IamSid44/VLSI-Project/Static Implementation/FPGA/CLA_4_Bit.runs/impl_1/.init_design.begin.rst

<?xml version="1.0"?>
<ProcessHandle Version="1" Minor="0">
    <Process Command=".planAhead." Owner="sidda" Host="ASUS-VIVOBOOK" Pid="15584">
    </Process>
</ProcessHandle>
