IamSid44/VLSI-Project/Static Implementation/FPGA/CLA_4_Bit.runs/impl_1/.vivado.begin.rst

<?xml version="1.0"?>
<ProcessHandle Version="1" Minor="0">
    <Process Command="vivado.bat" Owner="sidda" Host="ASUS-VIVOBOOK" Pid="15996" HostCore="16" HostMemory="016539365376">
    </Process>
</ProcessHandle>
