IamSid44/VLSI-Project/Static Implementation/FPGA/CLA_4_Bit.runs/synth_1/.vivado.begin.rst

<?xml version="1.0"?>
<ProcessHandle Version="1" Minor="0">
    <Process Command="vivado.bat" Owner="sidda" Host="ASUS-VIVOBOOK" Pid="4608" HostCore="16" HostMemory="016539365376">
    </Process>
</ProcessHandle>
