IamSid44/VLSI-Project/2023102040_VLSI_Project.pdf

# Design and Implementation of a 4 Bit CLA

Siddarth Gottumukkula
2023102040
Department of Electronics and Communication Engineering IIIT Hyderabad
siddarth.g@students.iiit.ac.in

Abstract—This project focuses on the design and implementation of a 4-bit Carry Look-Ahead Adder (CLA), a highperformance digital circuit for binary addition. The CLA architecture is chosen for its ability to significantly reduce propagation delay compared to traditional ripple carry adders, making it suitable for high-speed arithmetic operations in modern digital systems. Performance metrics, such as delay, power consumption, gate count, are evaluated to demonstrate the efficiency of the CLA. Data collection and simulations have been done using tools like NGSPICE, MAGIC layout tool and AMD Xilinx Vivado. This project aims to provide insights into efficient adder design techniques.

I. INTRODUCTION
Addition is a fundamental operation in digital systems, forming the basis of arithmetic and logic computations in processors, ALUs, and other hardware components. While traditional ripple carry adders (RCAs) offer a straightforward implementation, their performance is hindered by carry propagation delays, which grow linearly with the number of bits. To address this bottleneck, the Carry Look-Ahead Adder (CLA) employs a parallelized approach to generate and propagate carry signals, enabling faster computation (the worst case delay remains the same in both the implementations but the performance is much better on average). By precomputing carry signals based on input bits and leveraging efficient logic design, the CLA minimizes delay, making it a preferred choice for high-speed arithmetic operations.
A. Carry Look-Ahead Logic
The CLA uses the concepts of generate and propagate signals to precompute carry signals [2]. For two input bits Ai and Bi
, and the carry-in Ci−1 for bit i (The first bit will have a Cin and the final carry of the operation will be C3):
- Generate Signal (Gi): The generate signal determines if a carry will be generated at bit i, regardless of the input carry.
Gi = Ai
- Bi
- Propagate Signal (Pi): The propagate signal indicates if a carry from the previous stage will propagate through bit i.
Pi = Ai ⊕ Bi
- Carry-Out (Ci): The carry-out for each bit is computed using the generate and propagate signals:

Ci = Gi + (Pi

- Ci−1)
1) Carry Signal Evaluation: Using the carry-out equation recursively, the carry signals can be computed for all 4 bits as follows:

C0 = G0 + (P0 · Cin)
C1 = G1 + (P1 · C0) = G1 + P1 · (G0 + P0 · Cin)
C2 = G2 + (P2 · C1) = G2 + P2 · (G1 + P1 · (G0 + P0 · Cin))

This recursive method eliminates the need for sequential carry propagation, enabling parallel computation of carry signals.
2) Sum Signal Evaluation: Once the carry signals are determined, the sum for each bit is calculated using the XOR operation:
Si = Pi ⊕ Ci−1

The optimizations used and implementation details are discussed in this project.

B. Integration of Flip-Flops for Timing Stability

To ensure robust operation and eliminate timing issues, flip-flops are integrated at both the input and output stages of the Carry Look-Ahead Adder (CLA). This design choice ensures proper synchronization of signals and prevents glitches or metastability that could occur due to timing mismatches or high-frequency operations.

By clocking both the input and output flip-flops, the circuit aligns its operations with the system clock, eliminating race conditions and ensuring consistent timing. Output flip-flops store the final results of the CLA computation, ensuring that the outputs are held steady until the next clock cycle. This prevents premature changes in the outputs during high-speed operations.

The flip-flops are strategically placed to encapsulate the CLA logic. Each input signal (Ai
, Bi

, and C0) is fed into a
D flip-flop, clocked by a common system clock. This ensures that all input signals are synchronized before being processed by the CLA logic. The computed carry (C3) and sum bits (S0, S1, S2, S3) are captured by another set of D flip-flops at the output. This locks the results and prevents any glitches from propagating downstream.

II. FLIP-FLOP DESIGN
In this project, a True Single-Phase Clock (TSPC) D-Flip-Flop is employed for input and output synchronization in the Carry Look-Ahead Adder (CLA) circuit. The TSPC flip-flop is chosen for its simplicity, low power consumption, less area, and ability to operate at high frequencies, making it an ideal choice for high-speed digital systems [3].
A. Structure of the TSPC D-Flip-Flop
The TSPC D-Flip-Flop operates with a single clock phase, avoiding the need for complementary clock signals, which simplifies clock distribution. It consists of two main stages, a low level sensitive latch followed by a high level sensitive latch.

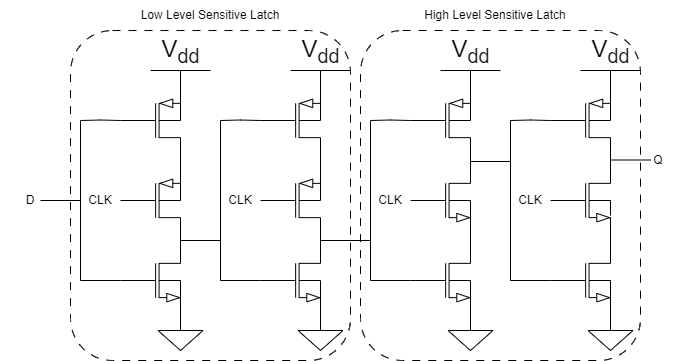
[picture p1: figure]

Fig. 1. TSPC D Flip-Flop circuit

The TSPC flip-flop’s operation is divided into two phases:
1) During the clock’s low phase (CLK = 0), the low level sensitive latch records the input but the output does not change as the high level sensitive latch is turned OFF.
2) During the clock’s high phase (CLK = 1), the low level sensitive latch turns OFF and the high level sensitive latch turns ON sending the previously recorded input to the output. Any change in the input in this phase will not affect the output.

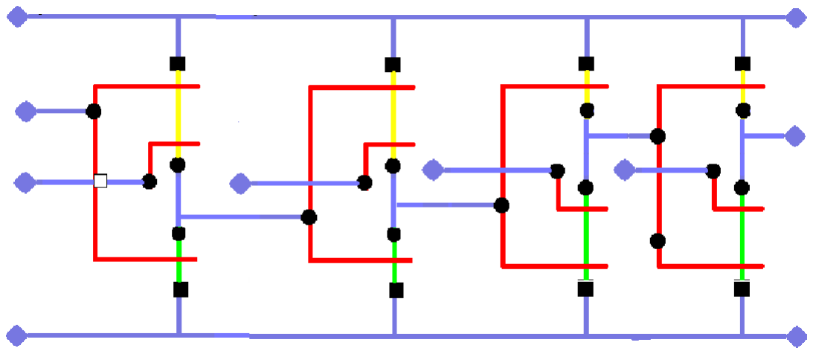
[picture p2: figure]

Fig. 2. Stick Diagram of the TSPC D FLip FLop

B. Timing Constraints
The TSPC D-Flip-Flop introduces certain timing constraints that must be satisfied for reliable operation:
- Setup Time (Tsetup): The minimum time the input data
(D) must be stable before the clock edge.
- Hold Time (Thold): The minimum time the input data
(D) must remain stable after the clock edge.
- Clock-to-Q Delay (TCQ): The time it takes for the output
(Q) to reflect a change in the input (D) after the clock edge.

The following table summarizes the relevant parameters of the TSPC D-Flip-Flop used in this project:

The optimizations used are listed below.

1) To reduce the body effect which might adversely affect the circuit, we short the bulk terminal to the source, instead of connecting it to the highest or the lowest voltage terminal in the circuit. This sets VSB = 0 and the threshold voltage remains unchanged in our analysis.
2) The widths of the PMOS transistors are scaled to twice the widths of the NMOS transistors in order to match the current carrying capabilities. This minimizes the difference in the rise and fall delays.

TABLE I
SIZING USED IN THE TSPC D FF, λ = 0.09µm
Element | PMOS | NMOS
Low Level Latch | 40λ | 10λ
High Level Latch | 20λ | 20λ

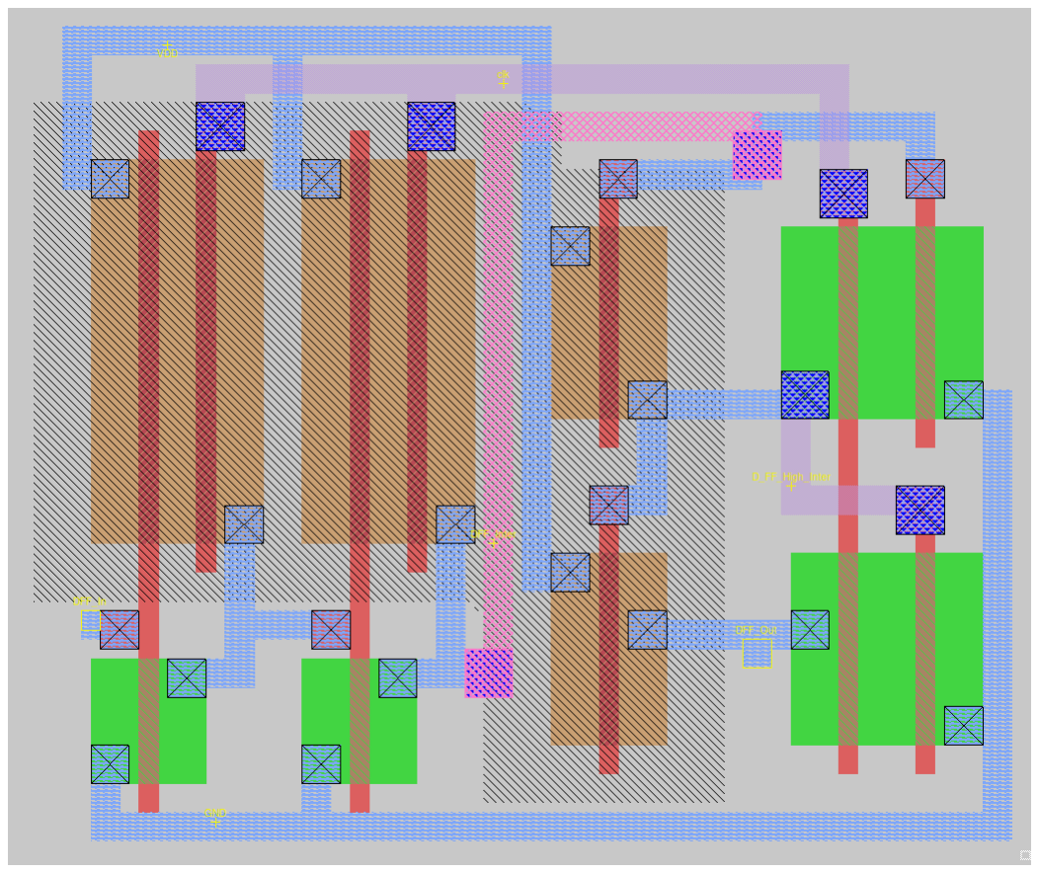
[picture p3: figure]

Fig. 3. Layout of TSPC D FF

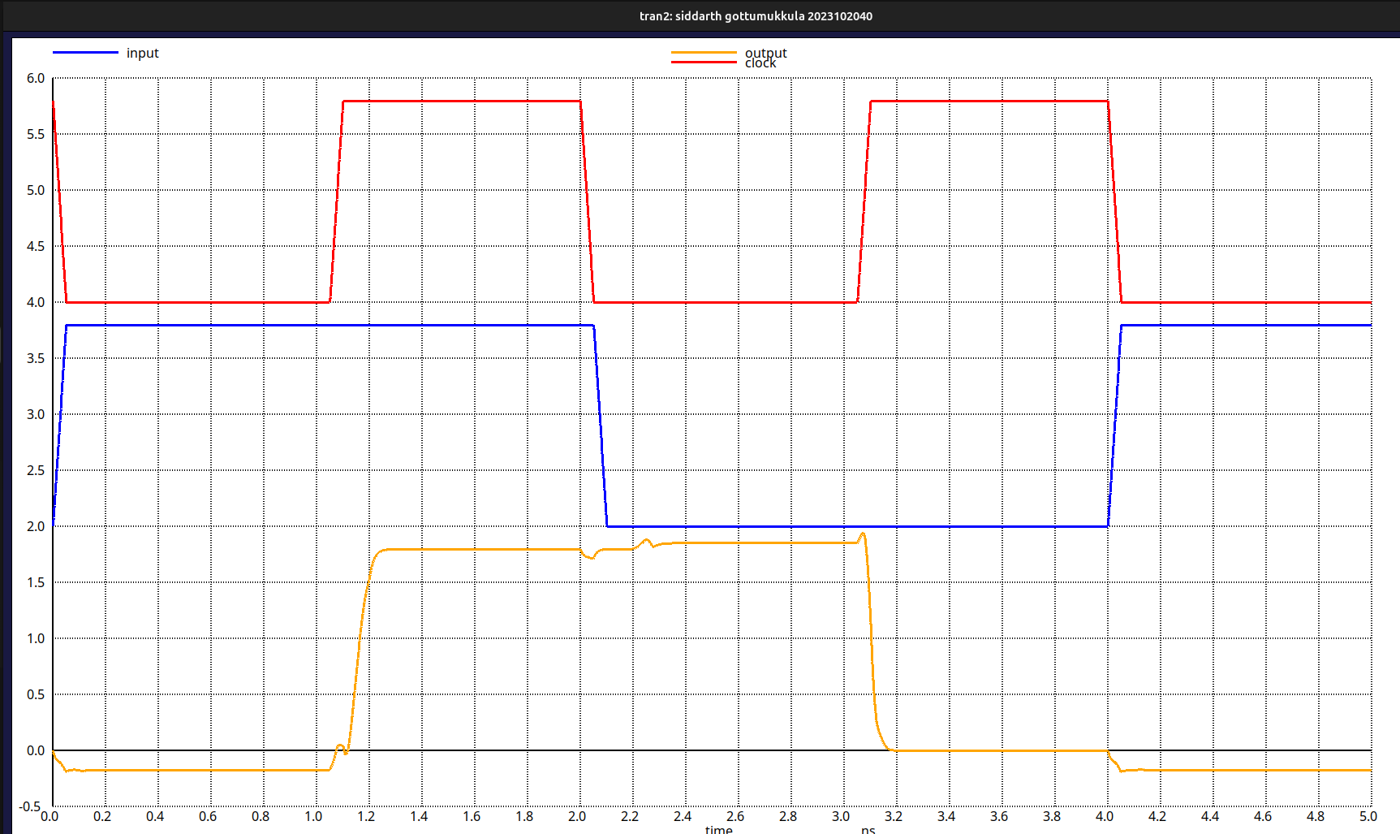
[picture p4: figure]

Fig. 4. Pre Layout Output of the FF

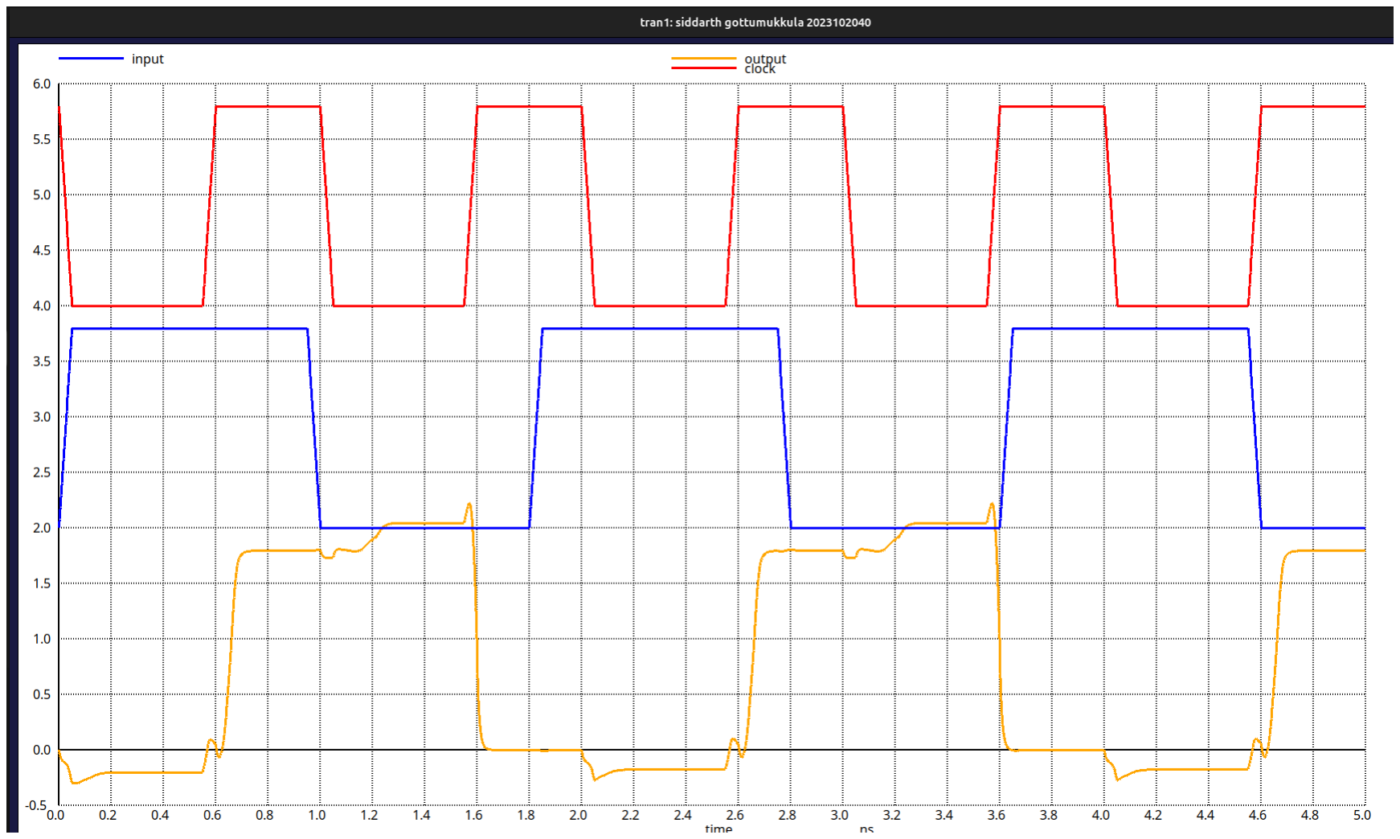
[picture p5: figure]

Fig. 5. Post Layout Output of the FF

The Flip-Flop was simulated using NGSPICE pre layout and post layout. The layout was done using MAGIC Layout tool. We expect differences in the values obtained pre layout and post layout not only due to parasitic capacitances present but also because of layout optimization techniques used. For example, the same diffusion region can act as the drain and source of two transistors instead of a wire connecting two separate regions. This cumulatively saves a huge amount of silicon area.

TABLE II
TSPC D-FLIP-FLOP PERFORMANCE DATA
Parameter | Pre Layout | Post Layout
Setup Time (Tsetup) | 121.97 ps | 129.57 ps
Hold Time (Thold) | 0 ps | 0 ps
Clock-to-Q Delay (Tclk to Q) | 84 ps | 82.7 ps

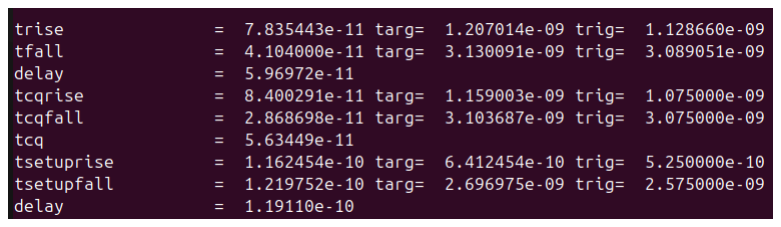
[picture p6: figure]

Fig. 6. Various parameters Pre Layout

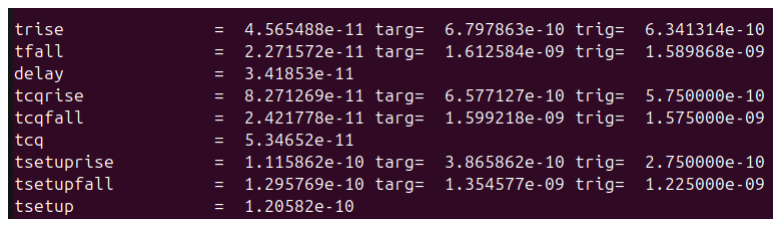
[picture p7: figure]

Fig. 7. Various parameters Post Layout

III. CLA IMPLEMENTATION

The implementation of the Carry Look-Ahead Adder (CLA) in this project focuses on achieving high-speed, powerefficient, and robust operation. A static CMOS logic style is chosen for the CLA circuit, as it offers several advantages over other logic styles, including dynamic logic and alternative static implementations.

A. Choosing a Logic Style

Static logic styles are preferred over dynamic logic styles in this design for the following reasons:
- Output Requirements: Given the constraint that the output must appear before at the next clock edge, there isn’t much flexibility to choose dynamic lofic styles. Implementing the different sections of the CLA using dynamic logic would take many clock cycles to produce the correct output. One strong contender in dynamic logic was to break the CLA implementation into two stages and use level sensitive logic implementations but it has other intricate complexities coming with it which are explained below.
- Charge redistribution: Static logic eliminates the risk of charge leakage and redistribution over time, which can lead to incorrect outputs in dynamic circuits. Solving this issue in dynamic circuits requires additional Keeper circuitry.
- Power Consumption: Unlike dynamic logic, static logic does not require precharge and evaluation phases, reducing the overall power consumption in the circuit. Static CMOS logic is used specifically for the CLA implementation due to its balance of performance, power, and reliability:
- Low Power Consumption: CMOS logic consumes power only during transitions, making it highly energyefficient compared to other static styles like pseudo-NMOS or pass-transistor logic.
- High Noise Margin: CMOS gates provide high noise margins, ensuring robust operation even under variations in supply voltage or process parameters.
- Design Simplicity: CMOS logic gates are straightforward to design and verify, reducing the complexity of the CLA implementation. item BiCMOS technology is another good option. However, circuits employing this style use the different families of transistors to their advantage. The bipolar junction transistors are used to handle the analog section (RF) of the circuit and the

CMOS technology is used to handle the ‘sea of logic’ [4]. Thus, for our purposes, BJT’s aren’t really necessary.

B. Circuit Implementation

The most basic circuit one can make is directly from the CLA expressions discussed in the introductory section, using OR and AND gates and XOR gates. However, we know that implementing a non-inverting logic will take up more resources. A possible implementation is to use NAND and NOR gates, the simplest implementation for which is detailed in [5]. A potential problem with this circuit is that a large number of inputs to a gate will result in a large capacitance, which will make the delay larger. We want to implement a circuit with a smaller parasitic capacitance, i.e., a smaller number of inputs. With a slight manipulation of the logic expressions, we observe that an implementation with just two input gates in possible [1]. We will explore this implementation further.

Another interesting implementation could be generating the output bits using a large single PUN and PDN [6]. However, to sizing of each of the transistors would be significantly higher than the basic implementation. The complexity also increases. Though it may prove to be faster due to lesser number fo logic stages the signal has to propagate through, the capacitance and the area would be drastically higher.

Another optimization that can be made to reduce the parasitic capacitance is to primarily use NOR gates instead of NAND gates. This will reduce the capacitance seen by the output node. The reason for this is that the PMOS stack will have a larger capacitance than the NMOS stack due to the sizing. Notice that the XOR in the Propagate signal can be changed to OR without affecting the output. This will reduce the complexity of the circuit. Let us redefine our logic expressions to inculcate these changes.

Pi = Ai + Bi for i ∈ {0, 1, 2, 3}

Gi = Ai

- Bi for i ∈ {0, 1, 2, 3}

Pi = Ai + Bi for i ∈ {0, 1, 2, 3}

Gi = Ai

- Bi for i ∈ {0, 1, 2, 3}

Pi

is the NOR of the input bits and Gi is the NAND of the
input bits.

C0 = G0 + P0 · Cin

= G0 · (P0 · Cin)

= G0 · (P0 + Cin)
C1 = G1 + P1 · G0 + P1 · P0 · Cin

= G1 · (P1 + G0) + (P1 + P0) · Cin
C2 = G2 + P2 · G1 + P2 · P1 · G0 + P2 · P1 · P0 · Cin

= G2 · (P2 + G1) + P2 · P1 · (G0 + P0 · Cin)

= G2 · (P2 + G1) + (P2 + P1) · G0 · P0 · Cin

= G2 · (P2 + G1) + (P2 + P1) · G0 · P0 + Cin C3 = G3 + P3 · G2 + P3 · P2 · G1 + P3 · P2 · P1 · G0 + P3 · P2 · P1 · P0 · Cin

We decompose C3 into two different intermediate expressions.

C3 = Gout + Pout · Cin

= Gout · (Pout + Cin)
Gout = G3 + P3 · G2 + P3 · P2 · G1 + P3 · P2 · P1 · G0
= G′
3
- (P

′

3 + G′
2

)

+ (P

′
3 + P

′
2

) · G′
1
- (P

′

1 + G′
0

)

Pout = P3 · P2 · P1 · P0

= P

′
3 + P

′
2
- P

′
1 + P

′
0

The stick diagrams of the logic gates used are drawn [8] and the sizing is explained in the later part of this section. The circuit implementing the logic can be designed as shown in [1].

TABLE III
LEGEND FOR THE STICK DIAGRAMS
Element | Color/Symbol
Metal 1 | Blue
P Diffusion | Yellow
N Diffusion | Green
Polysilicon | Red
Contact | Black Circle
Contact & Tap | Black Square
Metal 1 Port | Blue Diamond

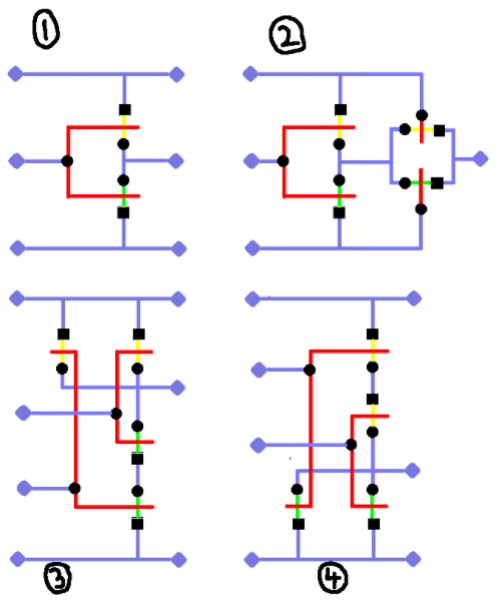
[picture p8: figure]

Fig. 8. Stick Diagrams of the gates NOT, XOR [9], NAND, NOR. These structures show how the transistors are connected in NGSPICE and MAGIC(for NOT and XOR). The color mapping is given below.

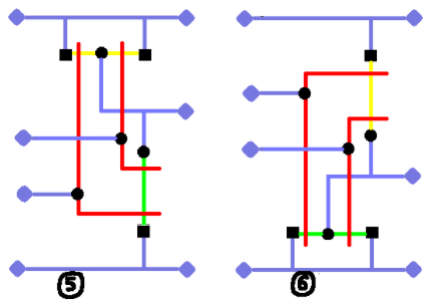
[picture p9: figure]

Fig. 9. In MAGIC, the common terminals are connected as shown for NAND and NOR gates. This gives us different results than the expected values from NGSPICE

To decide the sizing of the gates, we can use the method of logical effort [7]. The circuit, however, is too complex with multiple paths. Optimizing for a critical path might change the critical path which we will have to iterate over again. Thus, I have used a few general inferences to improve the circuit. For instance, the NAND and NOR gates which generate Gi and Pi are made larger to increase the driving capability. This trend can be seen from MLE as well. The logic gates in the middle section which compute the carry are sized smaller than the first layer of gates and the logic gates towards the end, before the output, are the smallest. This ensures less load and optimal current driving capabilities for each of the stages. The gate sizes are given in the table ?? and circuit diagram ?? has numbers on the logic gates indicating the types of gates used.

TABLE IV
SIZING USED IN THE TSPC D FF, λ = 0.09µm
Element | PMOS | NMOS | Numbering
Inverter | 22λ | 11 λ | 1
Small NOR | 10λ | 5λ | 2
Medium NOR | 40λ | 20λ | 3
Large NOR | 80λ | 40λ | 4
Small NAND | 20λ | 20λ | 5
Large NAND | 40λ | 40λ | 6

The XOR gate’s (7) Inverter part is made using the same parameters specified above. The analog transmission gate is made using Wp = 21λ, Wn = 5λ, these are the values that just satisfy all the DRCs. The AND gate (8) is made using the NAND gate and the Inverter. The OR gate (9) is made using the Medium NOR gate and the inverter. The values were initialized in an attempt to match the resistance to an inverter and later iterated over to find the current set of values.

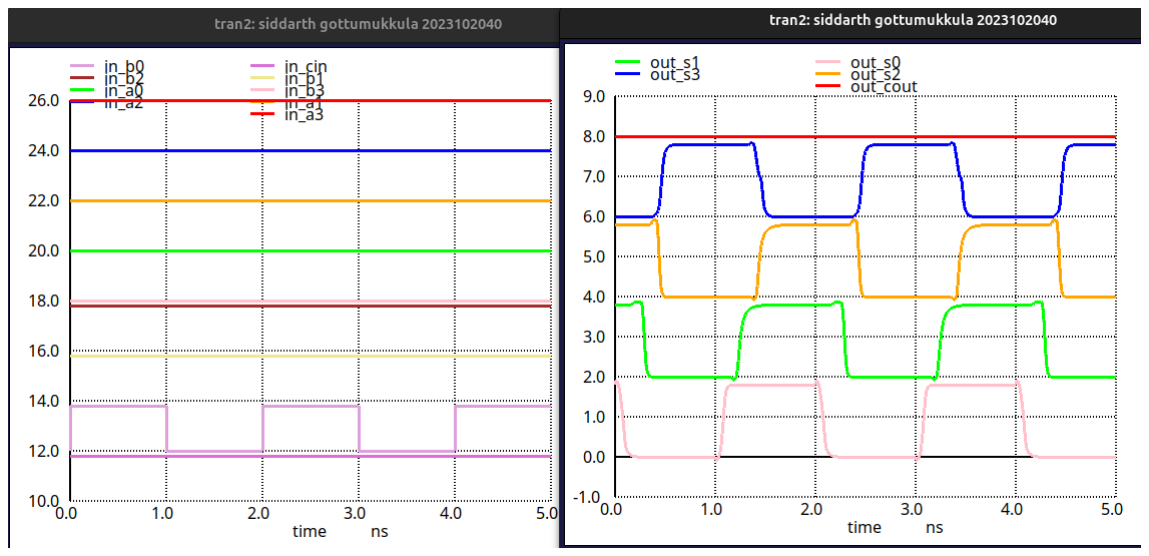
[picture p10: figure]

Fig. 10. CLA Pre Layout Output for the case, A = 0000, B = 0110 → 0111, C = 1. This is a case which tests the critical path from B0 to S3

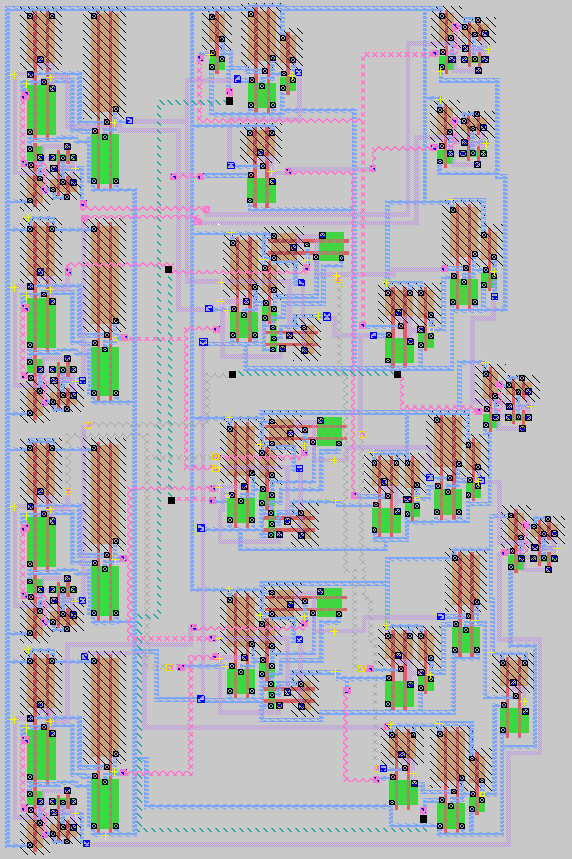
[picture p11: figure]

Fig. 11. CLA Layout

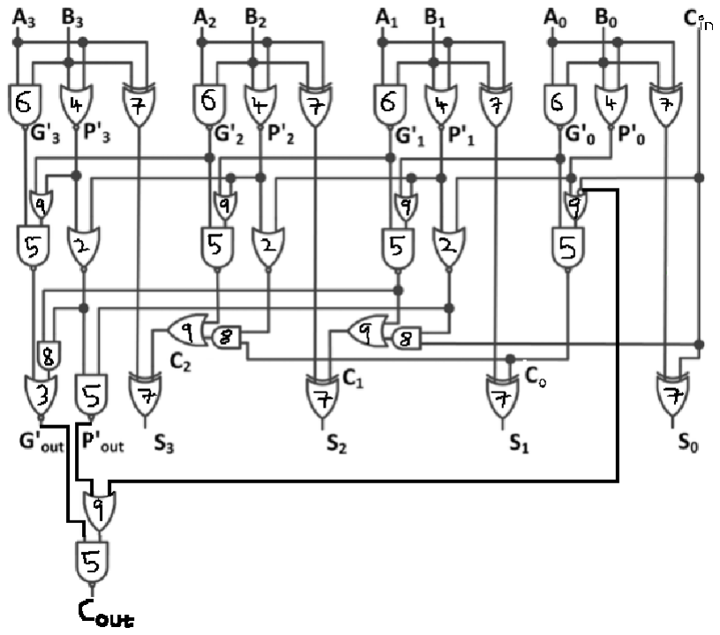
[picture p12: figure]

Fig. 12. Circuit Diagram [1] with gates numbered as mentioned in the table above

The critical path in the circuit would be one from B0 to S3. The critical path can be figured out by counting the number of gates in the path. We will take a test case and analyze the same test case in all the simulations unless stated otherwise.

The circuit can be broken down and implemented in three layers. The first layer generates the P and G signals along with a partial Sum bit signal. The next layer will involve intermediate computation of the carry bits and the final layer will compute the sum bit and produce the output ultimately.

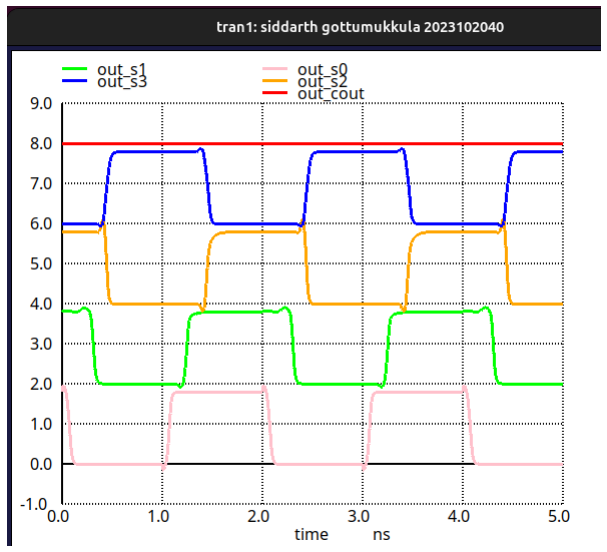
[picture p13: figure]

Fig. 13. CLA Post Layout Output for the same case

TABLE V
PARAMETERS OF THE 4-BIT CARRY LOOKAHEAD ADDER
Parameter | Value
Pre-Layout Propagation Delay (ns) | 459.98 ps
Post-Layout Propagation Delay (ns) | 449.57 ps
Pre-Layout Power Delay Product (PDP) | 20.7 pJ
Post-Layout Power Delay Product (PDP) | 20.23 pJ
Power Dissipation (mW) | 45 mW
Gate Count (Layout) | 54
Transistor Count (Layout) | 182
Layout Area | 2585.73 µm²
Horizontal Pitch | 41.22 µm
Vertical Pitch | 62.73 µm

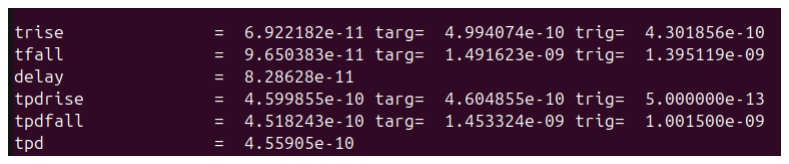
[picture p14: figure]

Fig. 14. Parameters Pre Layout for CLA

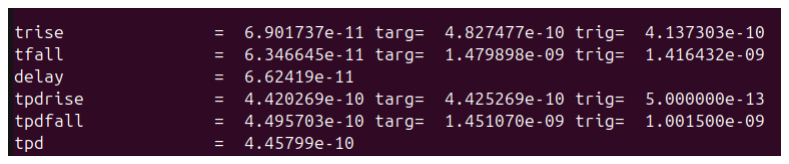
[picture p15: figure]

Fig. 15. Parameters Post Layout for CLA

Theoretically, we can come up with a bound for the maximum frequency using Static Timing Analysis.

tCQmax + tpdmax + tsu ≤ TClk

Using the above equation and the values extracted earlier, we get,

fmaxP relayout = 1.502 GHz

fmaxP ostlayout = 1.511 GHz

We will compare the actual frequency of operation obtained with this value later on.

IV. INTEGRATION
Floor planning has to be proper to ensure optimal circuit area.

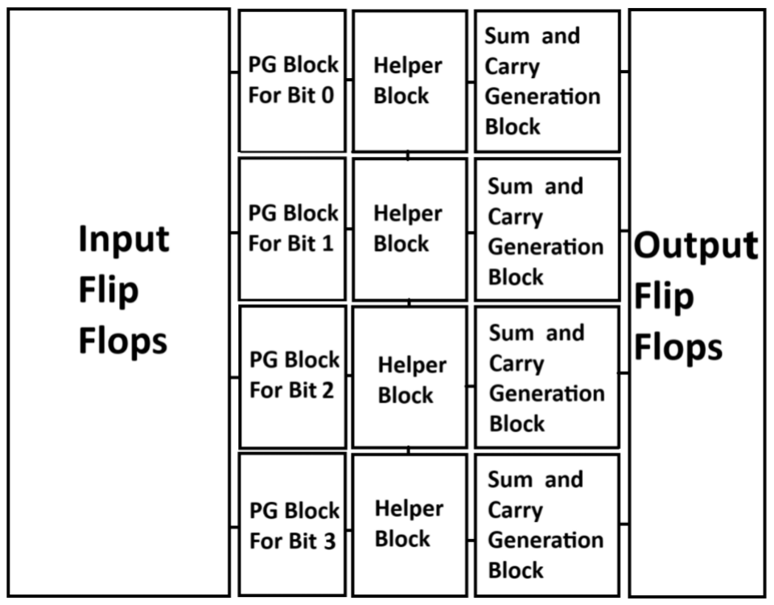
[picture p16: figure]

Fig. 16. Floor Plan for the Layout. The circuit is divided into these sub blocks and implemented for modularity

The circuit designing and performance metrics are specified below. They are extracted with an inverter

20λ
10λ
as load at each
of the flip flop outputs.

TABLE VI
PRE-LAYOUT VS POST-LAYOUT PARAMETERS OF THE 4-BIT CLA
Parameter | Value
Circuit Area | 4477.81 µm²
Transistor Count | 360
Horizontal Pitch | 62.82 µm
Vertical Pitch | 71.28 µm
Max Frequency Pre-Layout | 1.136 GHz
Min Time Period Pre-Layout | 0.88 ns
Max Frequency Post-Layout | 1.19 GHz
Min Time Period Post-Layout | 0.84 ns

We see that the maximum frequency of operation is 0.3 GHz lesser than what is expected theoretically. This arises due to various parameters such as loading and parasitics.

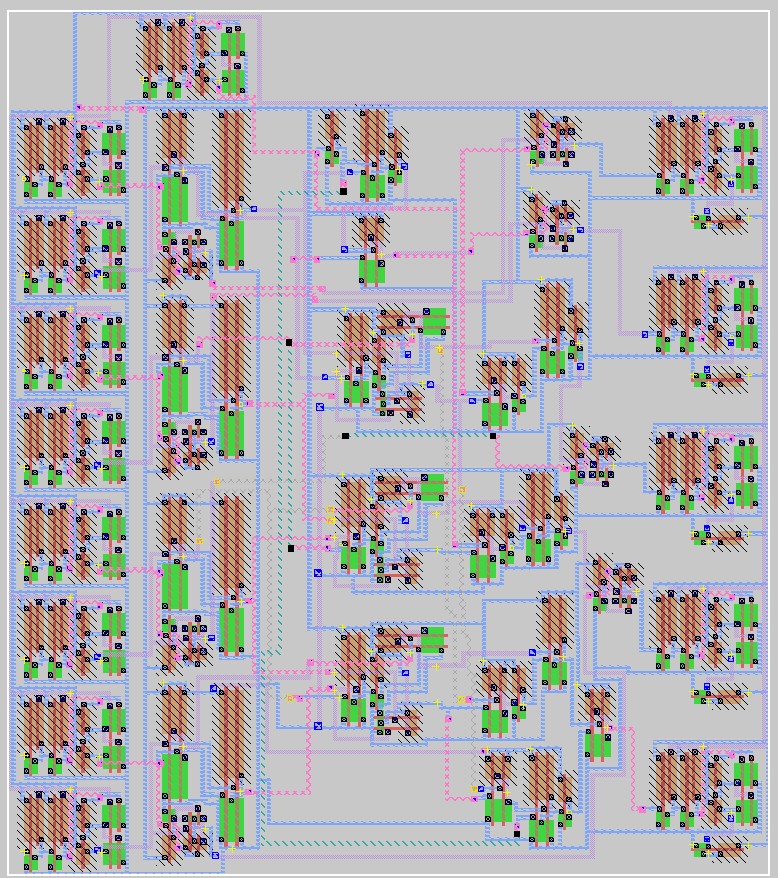
[picture p17: figure]

Fig. 17. Full Circuit Layout

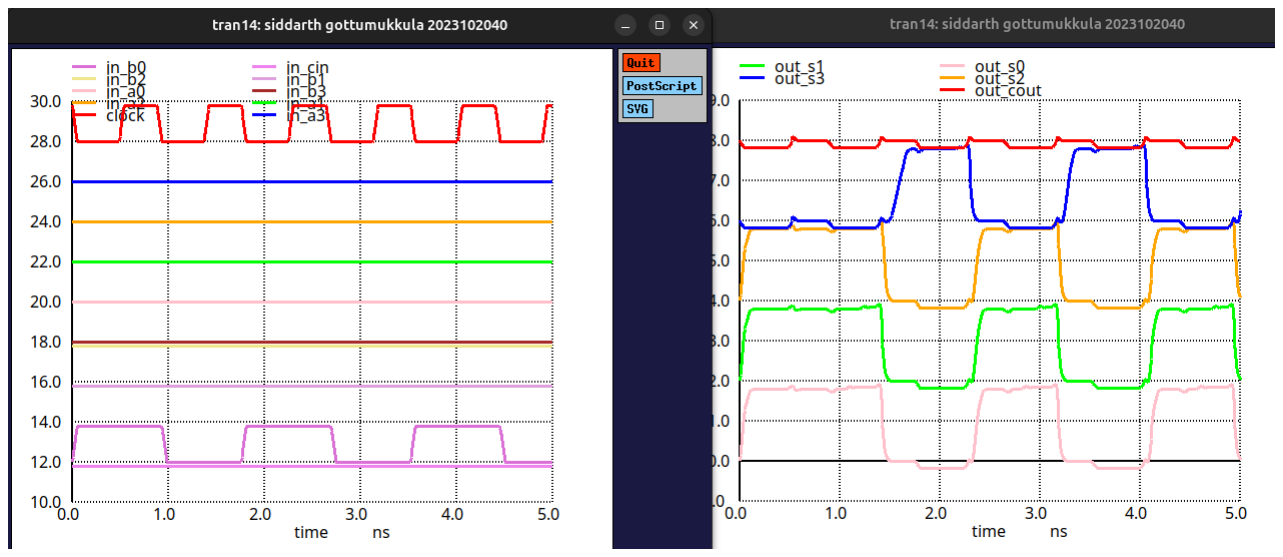
[picture p18: figure]

Fig. 18. Pre Layout Circuit operating at 1.136 GHz for the same critical test case

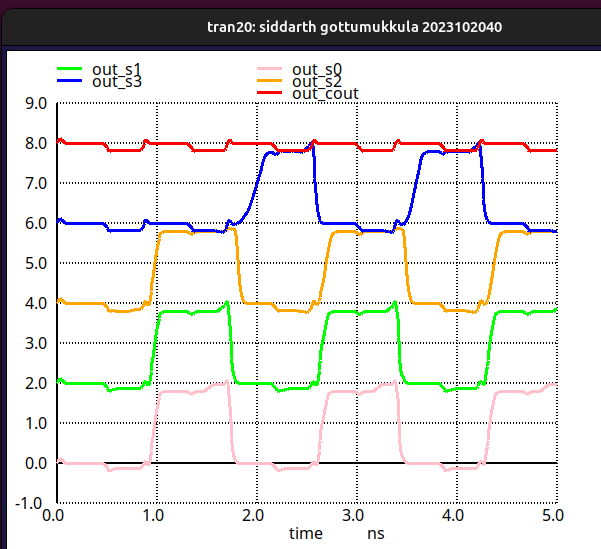
[picture p19: figure]

Fig. 19. Post Layout circuit operating at 1.19 GHz

We can verify the timing of the input and the output using Verilog. In structural level code, we need not worry about the sizing or voltage levels. It is purely for logic simulation and timing analysis which gives us insights into the working of the circuit.

Implementation has been carried out on the Xilinx Spartan-7 Boolean FPGA board. Using the PMOD pins, the output has been plotted on an Oscilloscope.

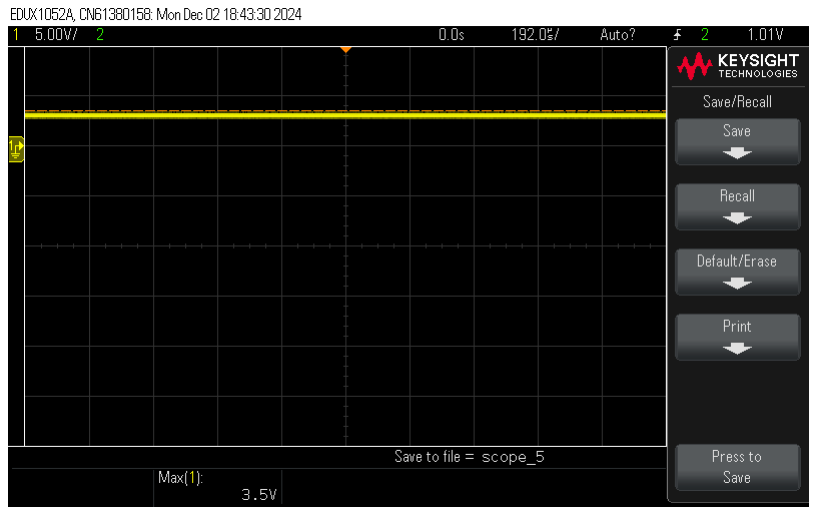
[picture p20: figure]

Fig. 21. Carry Bit for the input A = 13 (1011), B = 7 (0111), Cin = 1. The FPGA board outputs values between 0 V and 3.3 V through the PMOD pins. In the oscilloscope plots, 3.3 V is to be treated as logic level 1 and 0 is supposed to be treated as logic level 0. However, values observed are not exact due to noise. Repeaters can be added to tackle this issue. An other solution is to make the circuit following this circuit robust to noise by ensuring a good noise margin.

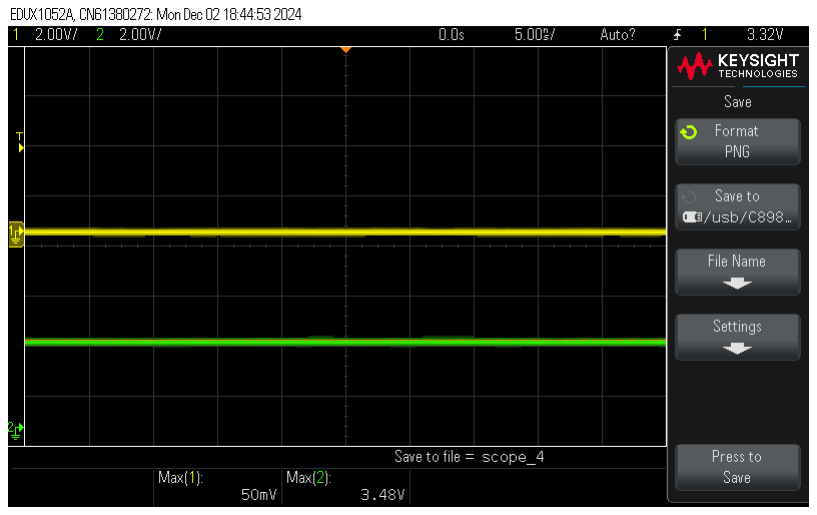
[picture p21: figure]

Fig. 22. S3 and S2 bits for the input A = 13 (1011), B = 7 (0111), Cin = 1

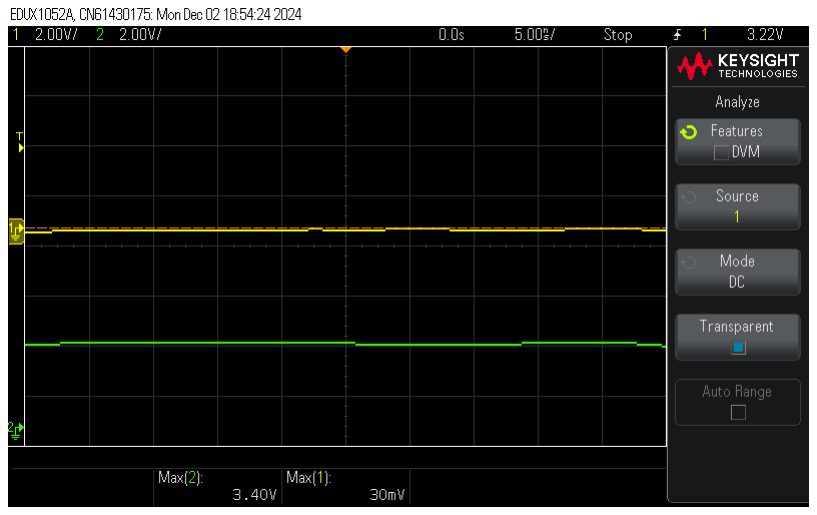
[picture p22: figure]

Fig. 23. S0 and S1 bits for the input A = 13 (1011), B = 7 (0111), Cin = 1

The final output of the case A = 13 (1011) + B = 7 (0111) + Cin = 1 = 21 (10101)

Thus, with various parameters extracted above in line with theory and simulations run on both software and hardware, we can claim that the design was successful. There is quite some scope for improvement. The area can be optimized, the sizing can be tweaked, or the entire logic style can be changed for better performance!

ACKNOWLEDGMENT
I would like to express my sincere gratitude to Professor Abhishek Srivastava, whose guidance and expertise have been invaluable throughout this project. Their insightful lectures and encouragement inspired me to delve deeper into the design and implementation of the Carry Lookahead Adder.
I am also deeply thankful to the Teaching Assistants, Karthikeya and Rathan, for their support and for addressing my queries promptly. Their feedback greatly contributed to the successful completion of this project.

REFERENCES

[1] J. Miao and S. Li,“A novel implementation of 4-bit carry look-ahead adder”, 2017 International Conference on Electron Devices and Solid-State Circuits (EDSSC), Hsinchu, Taiwan, 2017, pp. 1-2.

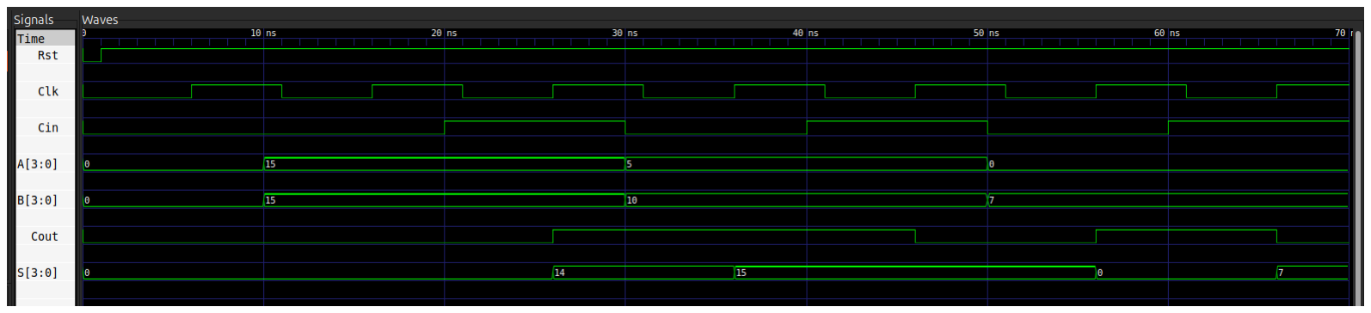
[picture p23: figure]

Fig. 20. Verilog output

[2] Mano, M. Morris, and Michael D. Ciletti. Digital Design: With an Introduction to the Verilog HDL, VHDL, and SystemVerilog. 5th edition. Pearson, 2012.
[3] B. Razavi, “TSPC Logic [A Circuit for All Seasons]”, in IEEE Solid-State Circuits Magazine, vol. 8, no. 4, pp. 10-13, Fall 2016.
[4] “BiCMOS”, Wikipedia, https://en.wikipedia.org/wiki/BiCMOS.
[5] Yu-Ting Pai and Yu-Kumg Chen, “The fastest carry lookahead adder,” Proceedings. DELTA 2004. Second IEEE International Workshop on Electronic Design, Test and Applications, Perth, WA, Australia, 2004, pp. 434-436.
[6] M. Hasan, P. Biswas, M. S. Alam, H. U. Zaman, M. Hossain and S. Islam, ”High Speed and Ultra Low Power Design of Carry-Out Bit of 4-Bit Carry Look-Ahead Adder,” 2019 10th International Conference on Computing, Communication and Networking Technologies (ICCCNT), Kanpur, India, 2019, pp. 1-5.
[7] Ivan E. Sutherland, Bob F. Sproull and David L. Harris. Logical Effort: Designing Fast CMOS Circuits, Morgan Kaufmann Publishers, 1998.
[8] Drawing | Stick | Diagrams, | Southampton | University,
https://www.southampton.ac.uk/ bim/notes/cad/guides/sticks.html.
[9] NS-SRAM: Neighborhood Solidarity SRAM for Reliability Enhancement of SRAM Memories - Scientific Figure on ResearchGate. Available from: https://www.researchgate.net/figure/mplementation-of-XOR-gatewith-four-transistors fig3 304142640.
