IamSid44/VLSI-Project/Images/CLA_Current_Post.png

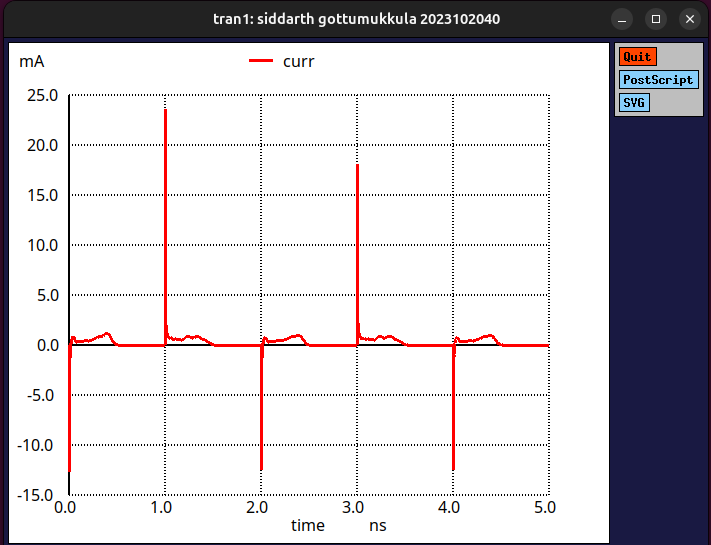
Images/CLA_Current_Post.png
