IamSid44/VLSI-Project/Images/CLA_Current_Pre.png

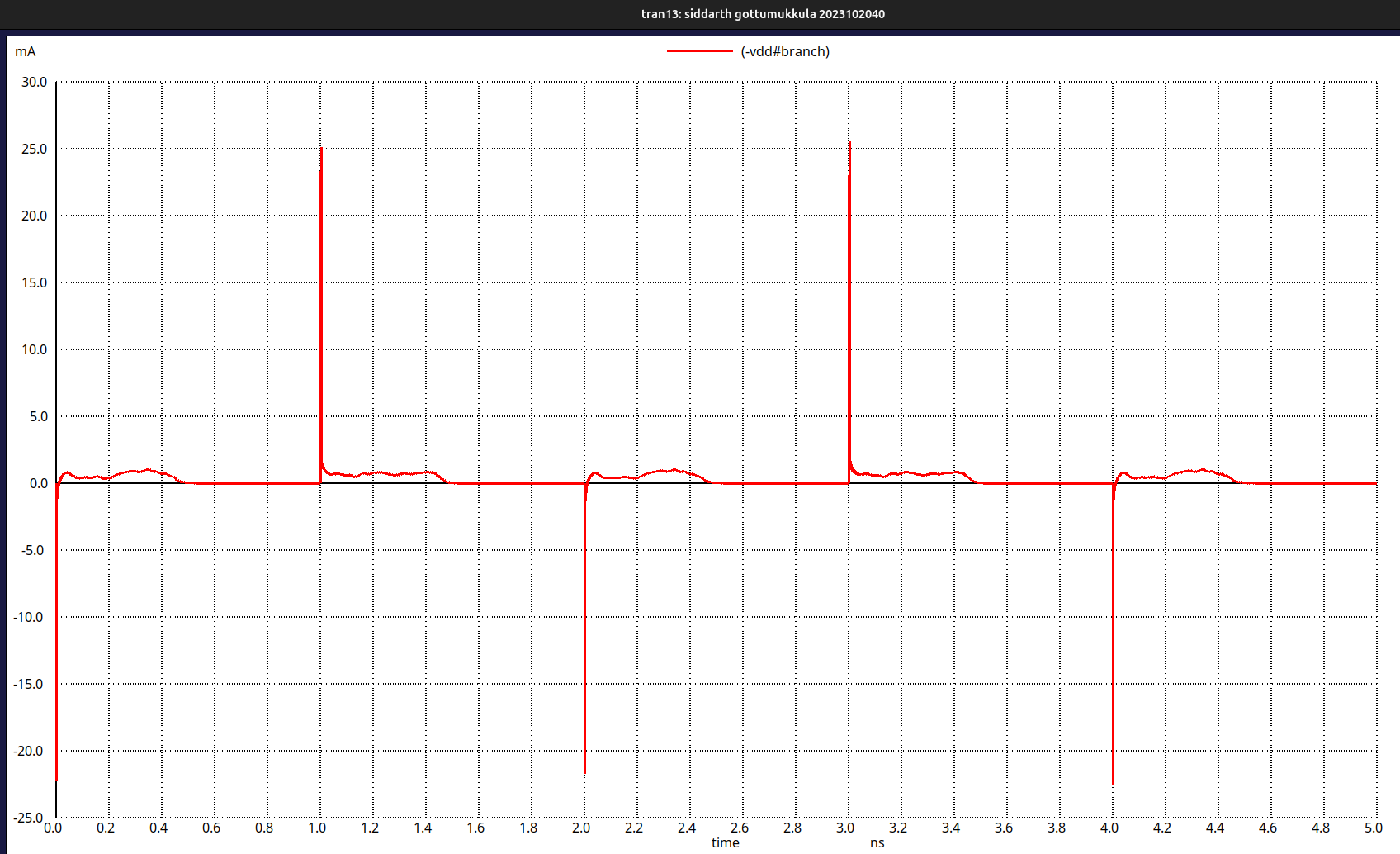
Images/CLA_Current_Pre.png
