IamSid44/VLSI-Project/Images/CLA_Post.png

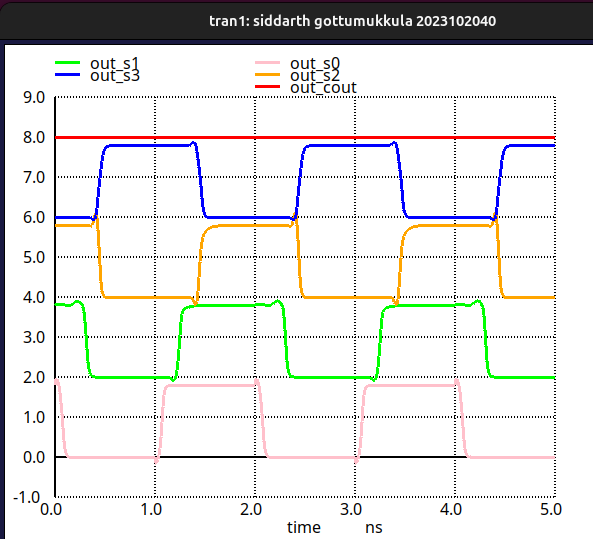
Images/CLA_Post.png
