IamSid44/VLSI-Project/Images/CLA_Pre.png

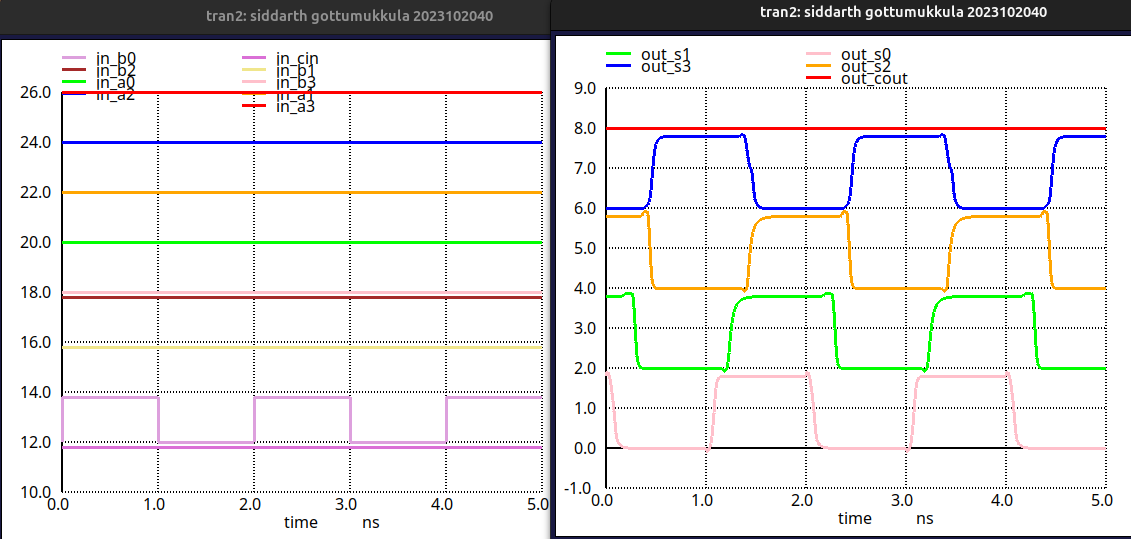
Images/CLA_Pre.png
