IamSid44/VLSI-Project/Images/Full_Circuit_Pre.png

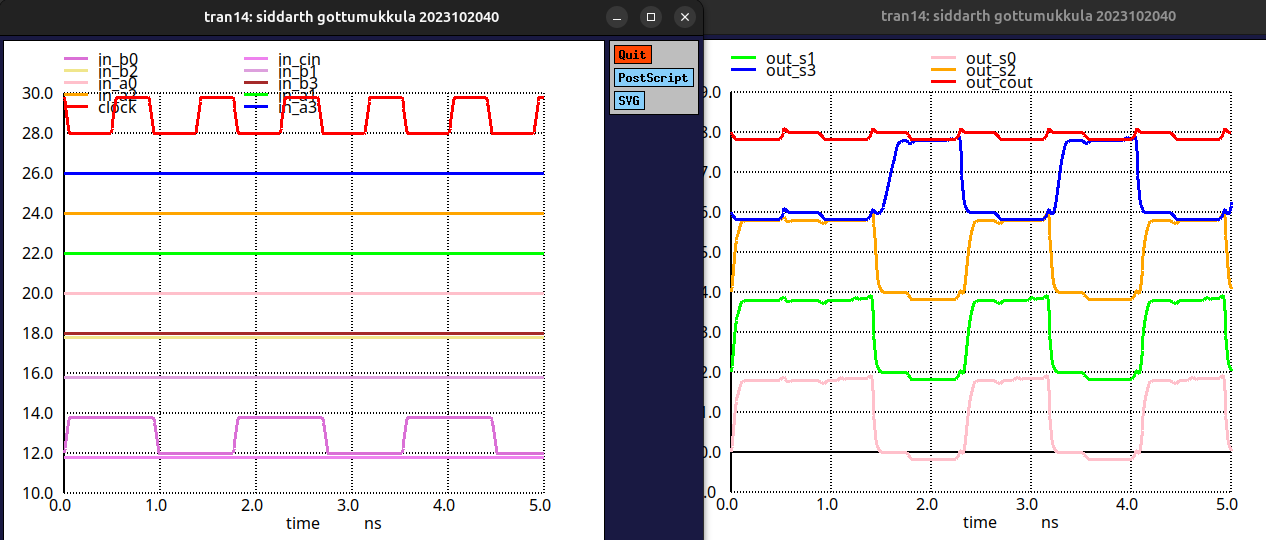
Images/Full_Circuit_Pre.png
