IamSid44/VLSI-Project/Images/TSPC_FF_Post.png

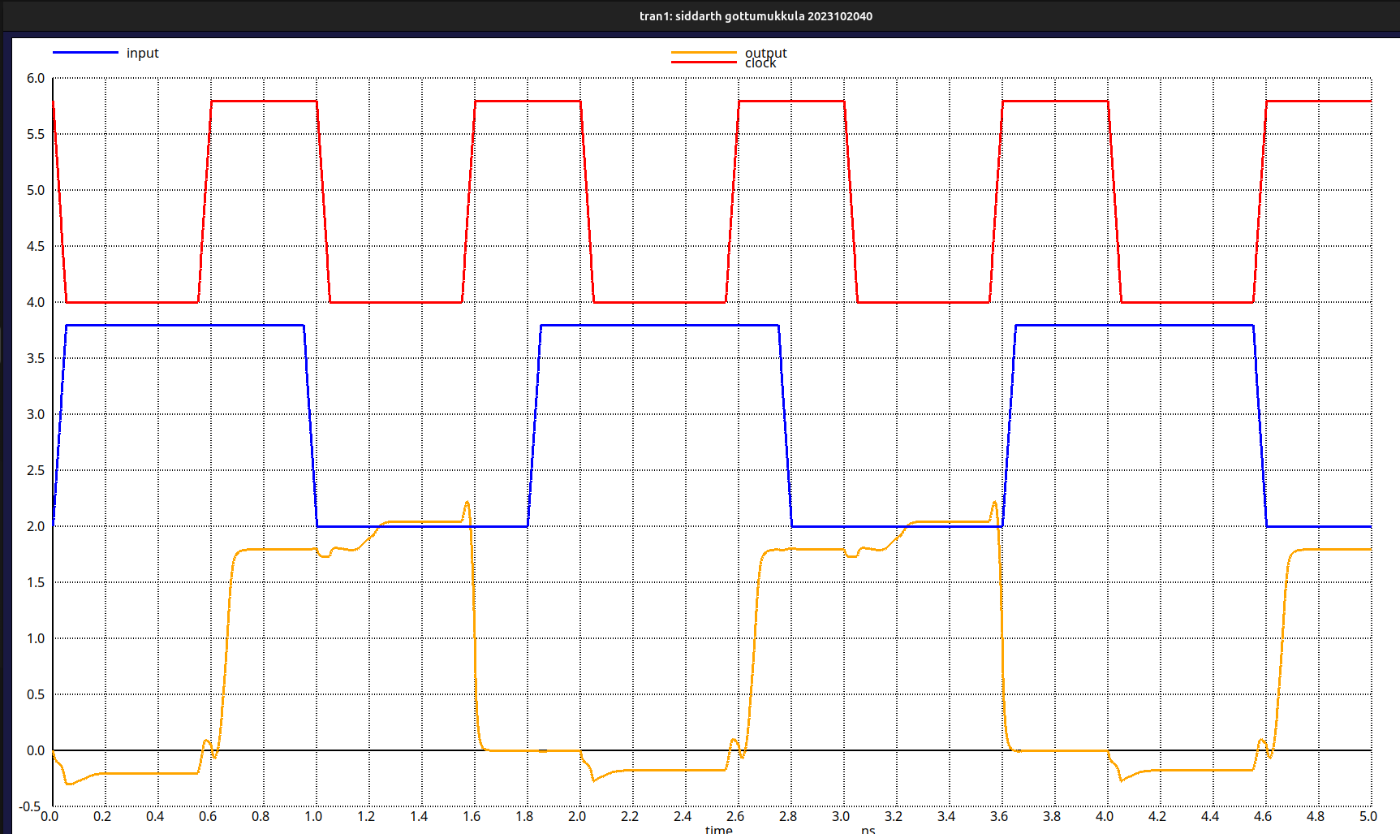
Images/TSPC_FF_Post.png
