IamSid44/VLSI-Project/Images/Verilog_Output.png

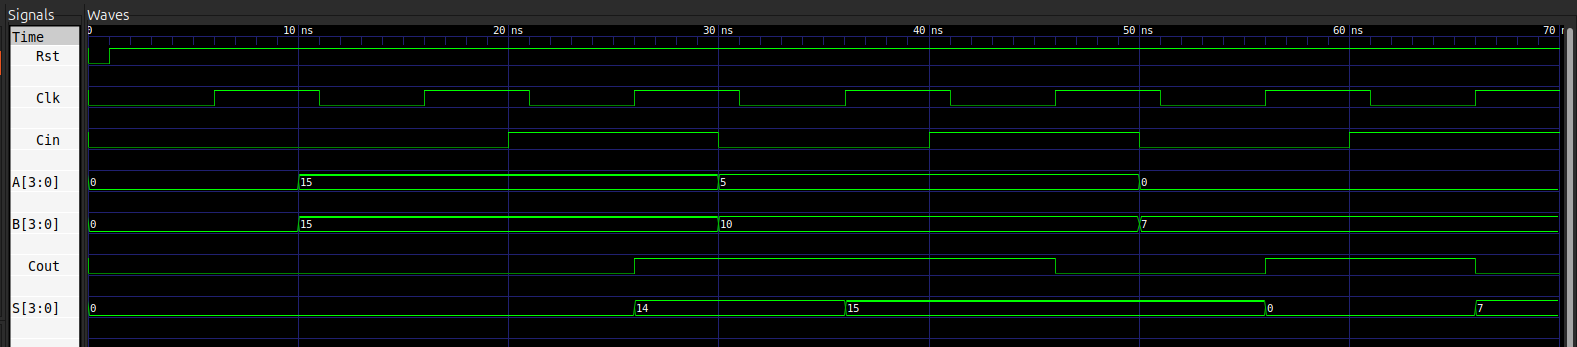
Images/Verilog_Output.png
