IamSid44/VLSI-Project/Static Implementation/FPGA/CLA_4_Bit.runs/impl_1/usage_statistics_webtalk.html

### Device Usage Page (usage_statistics_webtalk.html)

This HTML page displays the device usage statistics that will be sent to Xilinx.
To see the actual file transmitted to Xilinx, please click here.

software_version_and_target_device
beta | FALSE | build_version | 2708876
date_generated | Mon Dec 2 16:49:02 2024 | os_platform | WIN64
product_version | Vivado v2019.2 (64-bit) | project_id | 201cc5fcc7c041e58b3eeb306ba6ea30
project_iteration | 6 | random_id | c67392146dea534f8f3d5c66b80958ad
registration_id | c67392146dea534f8f3d5c66b80958ad | route_design | TRUE
target_device | xc7s50 | target_family | spartan7
target_package | csga324 | target_speed | -1
tool_flow | Vivado

user_environment
cpu_name | AMD Ryzen 7 5800HS with Radeon Graphics | cpu_speed | 3194 MHz
os_name | Windows Server 2016 or Windows 10 | os_release | major release (build 9200)
system_ram | 16.000 GB | total_processors | 1

vivado_usage

gui_handlers
addsrcwizard_specify_or_create_constraint_files=1 | basedialog_cancel=3 | basedialog_ok=7 | cmdmsgdialog_ok=8
constraintschooserpanel_create_file=1 | createconstraintsfilepanel_file_name=1 | filesetpanel_file_set_panel_tree=45 | filesetpanel_messages=1
flownavigatortreepanel_flow_navigator_tree=13 | fpgachooser_fpga_table=1 | fpgachooser_package=1 | fpgachooser_speed=1
gettingstartedview_create_new_project=2 | hcodeeditor_close=1 | hcodeeditor_search_text_combo_box=3 | mainmenumgr_file=4
mainmenumgr_open_recent_project=2 | mainmenumgr_project=4 | msgview_critical_warnings=2 | pacommandnames_add_sources=3
pacommandnames_auto_connect_target=3 | pacommandnames_open_hardware_manager=1 | pacommandnames_open_project=1 | paviews_project_summary=4
programdebugtab_open_target=3 | programdebugtab_program_device=14 | programdebugtab_refresh_device=8 | programfpgadialog_program=13
projectnamechooser_choose_project_location=4 | projectnamechooser_create_project_subdirectory=3 | projectnamechooser_project_name=2 | saveprojectutils_save=2
srcchooserpanel_add_hdl_and_netlist_files_to_your_project=1 | srcchooserpanel_add_or_create_source_file=1 | syntheticagettingstartedview_recent_projects=1 | taskbanner_close=2

java_command_handlers
addsources=3 | autoconnecttarget=3 | closeproject=1 | editcopy=1
launchprogramfpga=14 | newproject=2 | openhardwaremanager=3 | openproject=1
openrecenttarget=3 | programdevice=1 | refreshdevice=7 | runbitgen=6
runimplementation=1 | runsynthesis=1 | viewtaskimplementation=1

other_data

guimode=4

project_data
constraintsetcount=1 | core_container=false | currentimplrun=impl_1 | currentsynthesisrun=synth_1
default_library=xil_defaultlib | designmode=RTL | export_simulation_activehdl=0 | export_simulation_ies=0
export_simulation_modelsim=0 | export_simulation_questa=0 | export_simulation_riviera=0 | export_simulation_vcs=0
export_simulation_xsim=0 | implstrategy=Vivado Implementation Defaults | launch_simulation_activehdl=0 | launch_simulation_ies=0
launch_simulation_modelsim=0 | launch_simulation_questa=0 | launch_simulation_riviera=0 | launch_simulation_vcs=0
launch_simulation_xsim=0 | simulator_language=Mixed | srcsetcount=2 | synthesisstrategy=Vivado Synthesis Defaults
target_language=Verilog | target_simulator=XSim | totalimplruns=1 | totalsynthesisruns=1

unisim_transformation

post_unisim_transformation
bufg=1 | fdce=14 | ibuf=11 | lut1=1
lut3=1 | lut4=1 | lut5=4 | lut6=1
obuf=14 | vcc=14

pre_unisim_transformation
bufg=1 | fdce=14 | ibuf=11 | lut1=1
lut3=1 | lut4=1 | lut5=4 | lut6=1
obuf=14 | vcc=14

phys_opt_design_post_place

command_line_options
-aggressive_hold_fix=default::[not_specified] | -bram_register_opt=default::[not_specified] | -clock_opt=default::[not_specified] | -critical_cell_opt=default::[not_specified]
-critical_pin_opt=default::[not_specified] | -directive=default::[not_specified] | -dsp_register_opt=default::[not_specified] | -effort_level=default::[not_specified]
-fanout_opt=default::[not_specified] | -hold_fix=default::[not_specified] | -insert_negative_edge_ffs=default::[not_specified] | -multi_clock_opt=default::[not_specified]
-placement_opt=default::[not_specified] | -restruct_opt=default::[not_specified] | -retime=default::[not_specified] | -rewire=default::[not_specified]
-shift_register_opt=default::[not_specified] | -uram_register_opt=default::[not_specified] | -verbose=default::[not_specified] | -vhfn=default::[not_specified]

report_drc

command_line_options
-append=default::[not_specified] | -checks=default::[not_specified] | -fail_on=default::[not_specified] | -force=default::[not_specified]
-format=default::[not_specified] | -internal=default::[not_specified] | -internal_only=default::[not_specified] | -messages=default::[not_specified]
-name=default::[not_specified] | -no_waivers=default::[not_specified] | -return_string=default::[not_specified] | -ruledecks=default::[not_specified]
-upgrade_cw=default::[not_specified] | -waived=default::[not_specified]

results

plck-12=1

report_methodology

command_line_options
-append=default::[not_specified] | -checks=default::[not_specified] | -fail_on=default::[not_specified] | -force=default::[not_specified]
-format=default::[not_specified] | -messages=default::[not_specified] | -name=default::[not_specified] | -return_string=default::[not_specified]
-slack_lesser_than=default::[not_specified] | -waived=default::[not_specified]

results

timing-17=14

report_power

command_line_options
-advisory=default::[not_specified] | -append=default::[not_specified] | -file=[specified] | -format=default::text
-hier=default::power | -hierarchical_depth=default::4 | -l=default::[not_specified] | -name=default::[not_specified]
-no_propagation=default::[not_specified] | -return_string=default::[not_specified] | -rpx=[specified] | -verbose=default::[not_specified]
-vid=default::[not_specified] | -xpe=default::[not_specified]

usage
airflow=250 (LFM) | ambient_temp=25.0 (C) | bi-dir_toggle=12.500000 | bidir_output_enable=1.000000
board_layers=12to15 (12 to 15 Layers) | board_selection=medium (10"x10") | confidence_level_clock_activity=Low | confidence_level_design_state=High
confidence_level_device_models=High | confidence_level_internal_activity=High | confidence_level_io_activity=Low | confidence_level_overall=Low
customer=TBD | customer_class=TBD | devstatic=0.247539 | die=xc7s50csga324-1
dsp_output_toggle=12.500000 | dynamic=14.685291 | effective_thetaja=4.9 | enable_probability=0.990000
family=spartan7 | ff_toggle=12.500000 | flow_state=routed | heatsink=medium (Medium Profile)
i/o=14.415726 | input_toggle=12.500000 | junction_temp=98.8 (C) | logic=0.040259
netlist_net_matched=NA | off-chip_power=0.000000 | on-chip_power=14.932831 | output_enable=1.000000
output_load=5.000000 | output_toggle=12.500000 | package=csga324 | pct_clock_constrained=1.000000
pct_inputs_defined=0 | platform=nt64 | process=typical | ram_enable=50.000000
ram_write=50.000000 | read_saif=False | set/reset_probability=0.000000 | signal_rate=False
signals=0.229307 | simulation_file=None | speedgrade=-1 | static_prob=False
temp_grade=commercial | thetajb=7.6 (C/W) | thetasa=4.6 (C/W) | toggle_rate=False
user_board_temp=25.0 (C) | user_effective_thetaja=4.9 | user_junc_temp=98.8 (C) | user_thetajb=7.6 (C/W)
user_thetasa=4.6 (C/W) | vccadc_dynamic_current=0.000000 | vccadc_static_current=0.020000 | vccadc_total_current=0.020000
vccadc_voltage=1.800000 | vccaux_dynamic_current=0.526788 | vccaux_io_dynamic_current=0.000000 | vccaux_io_static_current=0.000000
vccaux_io_total_current=0.000000 | vccaux_io_voltage=1.800000 | vccaux_static_current=0.029393 | vccaux_total_current=0.556181
vccaux_voltage=1.800000 | vccbram_dynamic_current=0.000000 | vccbram_static_current=0.003943 | vccbram_total_current=0.003943
vccbram_voltage=1.000000 | vccint_dynamic_current=0.309565 | vccint_static_current=0.151388 | vccint_total_current=0.460953
vccint_voltage=1.000000 | vcco12_dynamic_current=0.000000 | vcco12_static_current=0.000000 | vcco12_total_current=0.000000
vcco12_voltage=1.200000 | vcco135_dynamic_current=0.000000 | vcco135_static_current=0.000000 | vcco135_total_current=0.000000
vcco135_voltage=1.350000 | vcco15_dynamic_current=0.000000 | vcco15_static_current=0.000000 | vcco15_total_current=0.000000
vcco15_voltage=1.500000 | vcco18_dynamic_current=0.000000 | vcco18_static_current=0.000000 | vcco18_total_current=0.000000
vcco18_voltage=1.800000 | vcco25_dynamic_current=0.000000 | vcco25_static_current=0.000000 | vcco25_total_current=0.000000
vcco25_voltage=2.500000 | vcco33_dynamic_current=4.068942 | vcco33_static_current=0.001000 | vcco33_total_current=4.069942
vcco33_voltage=3.300000 | version=2019.2

report_utilization

clocking
bufgctrl_available=32 | bufgctrl_fixed=0 | bufgctrl_used=1 | bufgctrl_util_percentage=3.13
bufhce_available=72 | bufhce_fixed=0 | bufhce_used=0 | bufhce_util_percentage=0.00
bufio_available=20 | bufio_fixed=0 | bufio_used=0 | bufio_util_percentage=0.00
bufmrce_available=10 | bufmrce_fixed=0 | bufmrce_used=0 | bufmrce_util_percentage=0.00
bufr_available=20 | bufr_fixed=0 | bufr_used=0 | bufr_util_percentage=0.00
mmcme2_adv_available=5 | mmcme2_adv_fixed=0 | mmcme2_adv_used=0 | mmcme2_adv_util_percentage=0.00
plle2_adv_available=5 | plle2_adv_fixed=0 | plle2_adv_used=0 | plle2_adv_util_percentage=0.00

dsp
dsps_available=120 | dsps_fixed=0 | dsps_used=0 | dsps_util_percentage=0.00

io_standard
blvds_25=0 | diff_hstl_i=0 | diff_hstl_i_18=0 | diff_hstl_ii=0
diff_hstl_ii_18=0 | diff_hsul_12=0 | diff_mobile_ddr=0 | diff_sstl135=0
diff_sstl135_r=0 | diff_sstl15=0 | diff_sstl15_r=0 | diff_sstl18_i=0
diff_sstl18_ii=0 | hstl_i=0 | hstl_i_18=0 | hstl_ii=0
hstl_ii_18=0 | hsul_12=0 | lvcmos12=0 | lvcmos15=0
lvcmos18=0 | lvcmos25=0 | lvcmos33=1 | lvds_25=0
lvttl=0 | mini_lvds_25=0 | mobile_ddr=0 | pci33_3=0
ppds_25=0 | rsds_25=0 | sstl135=0 | sstl135_r=0
sstl15=0 | sstl15_r=0 | sstl18_i=0 | sstl18_ii=0

tmds_33=0

memory
block_ram_tile_available=75 | block_ram_tile_fixed=0 | block_ram_tile_used=0 | block_ram_tile_util_percentage=0.00
ramb18_available=150 | ramb18_fixed=0 | ramb18_used=0 | ramb18_util_percentage=0.00
ramb36_fifo_available=75 | ramb36_fifo_fixed=0 | ramb36_fifo_used=0 | ramb36_fifo_util_percentage=0.00

primitives
bufg_functional_category=Clock | bufg_used=1 | fdce_functional_category=Flop & Latch | fdce_used=14
ibuf_functional_category=IO | ibuf_used=11 | lut1_functional_category=LUT | lut1_used=1
lut3_functional_category=LUT | lut3_used=1 | lut4_functional_category=LUT | lut4_used=1
lut5_functional_category=LUT | lut5_used=4 | lut6_functional_category=LUT | lut6_used=1
obuf_functional_category=IO | obuf_used=14

slice_logic
f7_muxes_available=16300 | f7_muxes_fixed=0 | f7_muxes_used=0 | f7_muxes_util_percentage=0.00
f8_muxes_available=8150 | f8_muxes_fixed=0 | f8_muxes_used=0 | f8_muxes_util_percentage=0.00
lut_as_logic_available=32600 | lut_as_logic_fixed=0 | lut_as_logic_used=7 | lut_as_logic_util_percentage=0.02
lut_as_memory_available=9600 | lut_as_memory_fixed=0 | lut_as_memory_used=0 | lut_as_memory_util_percentage=0.00
register_as_flip_flop_available=65200 | register_as_flip_flop_fixed=0 | register_as_flip_flop_used=14 | register_as_flip_flop_util_percentage=0.02
register_as_latch_available=65200 | register_as_latch_fixed=0 | register_as_latch_used=0 | register_as_latch_util_percentage=0.00
slice_luts_available=32600 | slice_luts_fixed=0 | slice_luts_used=7 | slice_luts_util_percentage=0.02
slice_registers_available=65200 | slice_registers_fixed=0 | slice_registers_used=14 | slice_registers_util_percentage=0.02
lut_as_distributed_ram_fixed=0 | lut_as_distributed_ram_used=0 | lut_as_logic_available=32600 | lut_as_logic_fixed=0
lut_as_logic_used=7 | lut_as_logic_util_percentage=0.02 | lut_as_memory_available=9600 | lut_as_memory_fixed=0
lut_as_memory_used=0 | lut_as_memory_util_percentage=0.00 | lut_as_shift_register_fixed=0 | lut_as_shift_register_used=0
lut_in_front_of_the_register_is_unused_fixed=0 | lut_in_front_of_the_register_is_unused_used=8 | lut_in_front_of_the_register_is_used_fixed=8 | lut_in_front_of_the_register_is_used_used=1
register_driven_from_outside_the_slice_fixed=1 | register_driven_from_outside_the_slice_used=9 | register_driven_from_within_the_slice_fixed=9 | register_driven_from_within_the_slice_used=5
slice_available=8150 | slice_fixed=0 | slice_registers_available=65200 | slice_registers_fixed=0
slice_registers_used=14 | slice_registers_util_percentage=0.02 | slice_used=5 | slice_util_percentage=0.06
slicel_fixed=0 | slicel_used=4 | slicem_fixed=0 | slicem_used=1
unique_control_sets_available=8150 | unique_control_sets_fixed=8150 | unique_control_sets_used=1 | unique_control_sets_util_percentage=0.01
using_o5_and_o6_fixed=0.01 | using_o5_and_o6_used=1 | using_o5_output_only_fixed=1 | using_o5_output_only_used=0
using_o6_output_only_fixed=0 | using_o6_output_only_used=6

specific_feature
bscane2_available=4 | bscane2_fixed=0 | bscane2_used=0 | bscane2_util_percentage=0.00
capturee2_available=1 | capturee2_fixed=0 | capturee2_used=0 | capturee2_util_percentage=0.00
dna_port_available=1 | dna_port_fixed=0 | dna_port_used=0 | dna_port_util_percentage=0.00
efuse_usr_available=1 | efuse_usr_fixed=0 | efuse_usr_used=0 | efuse_usr_util_percentage=0.00
frame_ecce2_available=1 | frame_ecce2_fixed=0 | frame_ecce2_used=0 | frame_ecce2_util_percentage=0.00
icape2_available=2 | icape2_fixed=0 | icape2_used=0 | icape2_util_percentage=0.00
startupe2_available=1 | startupe2_fixed=0 | startupe2_used=0 | startupe2_util_percentage=0.00
xadc_available=1 | xadc_fixed=0 | xadc_used=0 | xadc_util_percentage=0.00

synthesis

command_line_options
-assert=default::[not_specified] | -bufg=default::12 | -cascade_dsp=default::auto | -constrset=default::[not_specified]
-control_set_opt_threshold=default::auto | -directive=default::default | -fanout_limit=default::10000 | -flatten_hierarchy=default::rebuilt
-fsm_extraction=default::auto | -gated_clock_conversion=default::off | -generic=default::[not_specified] | -include_dirs=default::[not_specified]
-keep_equivalent_registers=default::[not_specified] | -max_bram=default::-1 | -max_bram_cascade_height=default::-1 | -max_dsp=default::-1
-max_uram=default::-1 | -max_uram_cascade_height=default::-1 | -mode=default::default | -name=default::[not_specified]
-no_lc=default::[not_specified] | -no_srlextract=default::[not_specified] | -no_timing_driven=default::[not_specified] | -part=xc7s50csga324-1
-resource_sharing=default::auto | -retiming=default::[not_specified] | -rtl=default::[not_specified] | -rtl_skip_constraints=default::[not_specified]
-rtl_skip_ip=default::[not_specified] | -seu_protect=default::none | -sfcu=default::[not_specified] | -shreg_min_size=default::3
-top=Adder | -verilog_define=default::[not_specified]

usage
elapsed=00:00:48s | hls_ip=0 | memory_gain=678.742MB | memory_peak=1128.242MB
