IamSid44/VLSI-Project/Static Implementation/MAGIC/CLA_Final/CLA_FF.spice

* SPICE3 file created from CLA_FF.ext - technology: scmos

.option scale=0.09u

M1000 P0_Not FB0 a_n847_38# w_n860_32# pfet w=80 l=2
+  ad=400 pd=170 as=640 ps=176
M1001 a_n562_72# FCin vdd w_n575_90# pfet w=22 l=2
+  ad=110 pd=54 as=17770 ps=8312
M1002 gnd a_n402_n363# a_n374_n386# Gnd nfet w=20 l=2
+  ad=10941 pd=5624 as=120 ps=52
M1003 a_n1004_n46# clk a_n1004_n21# w_n1039_n27# pfet w=40 l=2
+  ad=200 pd=90 as=160 ps=88
M1004 C1_Inter_NOR P1_Not gnd Gnd nfet w=5 l=2
+  ad=40 pd=26 as=0 ps=0
M1005 gnd a_n402_n508# a_n374_n531# Gnd nfet w=20 l=2
+  ad=0 pd=0 as=120 ps=52
M1006 S0 Inter_S0 a_n562_72# Gnd nfet w=5 l=2
+  ad=30 pd=22 as=90 ps=56
M1007 a_n981_n19# a_n1004_n46# vdd w_n1039_n27# pfet w=20 l=2
+  ad=100 pd=50 as=0 ps=0
M1008 a_n1026_n398# clk a_n1026_n373# w_n1039_n379# pfet w=40 l=2
+  ad=200 pd=90 as=160 ps=88
M1009 gnd C2_Inter_NAND a_n566_n292# Gnd nfet w=20 l=2
+  ad=0 pd=0 as=160 ps=56
M1010 a_n425_45# a_n447_45# gnd Gnd nfet w=13 l=2
+  ad=65 pd=36 as=0 ps=0
M1011 a_n847_n136# FA1 vdd w_n860_n142# pfet w=80 l=2
+  ad=640 pd=176 as=0 ps=0
M1012 a_n895_133# clk a_n895_158# w_n930_152# pfet w=40 l=2
+  ad=200 pd=90 as=160 ps=88
M1013 C1_Inter_NAND G1_Not a_n667_n77# Gnd nfet w=20 l=2
+  ad=120 pd=52 as=160 ps=56
M1014 C1 a_n553_n120# gnd Gnd nfet w=11 l=2
+  ad=85 pd=54 as=0 ps=0
M1015 S2 C1 Inter_S2 w_n539_n203# pfet w=10 l=2
+  ad=60 pd=32 as=110 ps=62
M1016 G2_Not FB2 vdd w_n912_n282# pfet w=40 l=2
+  ad=320 pd=96 as=0 ps=0
M1017 C3_Inter_04 a_n563_n549# gnd Gnd nfet w=11 l=2
+  ad=55 pd=32 as=0 ps=0
M1018 a_n425_n510# a_n447_n535# vdd w_n460_n516# pfet w=40 l=2
+  ad=160 pd=88 as=0 ps=0
M1019 FB3 FA3 Inter_S3 w_n912_n571# pfet w=10 l=2
+  ad=160 pd=82 as=110 ps=62
M1020 a_n1026_n574# clk a_n1026_n549# w_n1039_n555# pfet w=40 l=2
+  ad=200 pd=90 as=160 ps=88
M1021 a_n1004_n398# clk a_n1004_n373# w_n1039_n379# pfet w=40 l=2
+  ad=200 pd=90 as=160 ps=88
M1022 a_n512_n471# C3_Inter_04 gnd Gnd nfet w=20 l=2
+  ad=160 pd=56 as=0 ps=0
M1023 gnd FB1 P1_Not Gnd nfet w=40 l=2
+  ad=0 pd=0 as=320 ps=96
M1024 C2 a_n566_n292# vdd w_n630_n274# pfet w=22 l=2
+  ad=170 pd=86 as=0 ps=0
M1025 a_n617_n268# C0 a_n617_n307# Gnd nfet w=20 l=2
+  ad=120 pd=52 as=160 ps=56
M1026 a_n1004_n574# clk a_n1004_n549# w_n1039_n555# pfet w=40 l=2
+  ad=200 pd=90 as=160 ps=88
M1027 a_n735_n439# P3_Not a_n735_n400# w_n748_n406# pfet w=40 l=2
+  ad=200 pd=90 as=320 ps=96
M1028 FB3 a_n899_n565# Inter_S3 Gnd nfet w=5 l=2
+  ad=130 pd=72 as=30 ps=22
M1029 vdd C0_Inter_01 C0 w_n732_n4# pfet w=20 l=2
+  ad=0 pd=0 as=210 ps=86
M1030 a_n719_n37# G0_Not gnd Gnd nfet w=20 l=2
+  ad=160 pd=56 as=0 ps=0
M1031 a_n953_n306# clk FA2 Gnd nfet w=20 l=2
+  ad=120 pd=52 as=100 ps=50
M1032 a_n953_n536# clk a_n981_n547# Gnd nfet w=20 l=2
+  ad=120 pd=52 as=120 ps=52
M1033 vdd S3_FF Loaded_S3 w_n403_n428# pfet w=20 l=2
+  ad=0 pd=0 as=100 ps=50
M1034 a_n711_n371# a_n735_n439# gnd Gnd nfet w=11 l=2
+  ad=55 pd=32 as=0 ps=0
M1035 a_n606_n410# C3_Inter_NOR vdd w_n619_n416# pfet w=20 l=2
+  ad=160 pd=56 as=0 ps=0
M1036 a_n735_n260# G1_Not vdd w_n748_n266# pfet w=40 l=2
+  ad=320 pd=96 as=0 ps=0
M1037 a_n447_45# clk a_n447_70# w_n460_64# pfet w=40 l=2
+  ad=200 pd=90 as=160 ps=88
M1038 a_n844_171# clk a_n872_160# Gnd nfet w=20 l=2
+  ad=120 pd=52 as=120 ps=52
M1039 a_n953_46# clk FA0 Gnd nfet w=20 l=2
+  ad=120 pd=52 as=100 ps=50
M1040 C3_Inter_02 C3_Inter_NAND a_n551_n366# w_n564_n372# pfet w=40 l=2
+  ad=200 pd=90 as=320 ps=96
M1041 a_n953_n96# clk a_n981_n107# Gnd nfet w=20 l=2
+  ad=120 pd=52 as=120 ps=52
M1042 a_n733_n147# P1_Not a_n733_n108# w_n746_n114# pfet w=40 l=2
+  ad=200 pd=90 as=320 ps=96
M1043 a_n1026_n461# A3 vdd w_n1039_n467# pfet w=40 l=2
+  ad=160 pd=88 as=0 ps=0
M1044 a_n917_158# Cin vdd w_n930_152# pfet w=40 l=2
+  ad=160 pd=88 as=0 ps=0
M1045 a_n1026_n310# clk a_n1026_n285# w_n1039_n291# pfet w=40 l=2
+  ad=200 pd=90 as=160 ps=88
M1046 S3_FF a_n402_n363# vdd w_n460_n371# pfet w=20 l=2
+  ad=100 pd=50 as=0 ps=0
M1047 a_n718_41# P0_Not gnd Gnd nfet w=20 l=2
+  ad=160 pd=56 as=0 ps=0
M1048 a_n1004_n310# clk a_n1004_n285# w_n1039_n291# pfet w=40 l=2
+  ad=200 pd=90 as=160 ps=88
M1049 C2 a_n505_n337# S3 Gnd nfet w=5 l=2
+  ad=85 pd=54 as=30 ps=22
M1050 C_Out_FF a_n402_n508# vdd w_n460_n516# pfet w=20 l=2
+  ad=100 pd=50 as=0 ps=0
M1051 a_n847_n490# FA3 vdd w_n860_n496# pfet w=80 l=2
+  ad=640 pd=176 as=0 ps=0
M1052 a_n872_160# a_n895_133# vdd w_n930_152# pfet w=20 l=2
+  ad=100 pd=50 as=0 ps=0
M1053 FA0 a_n981_69# vdd w_n1039_61# pfet w=20 l=2
+  ad=150 pd=80 as=0 ps=0
M1054 a_n718_41# a_n750_72# a_n718_80# w_n731_74# pfet w=40 l=2
+  ad=200 pd=90 as=320 ps=96
M1055 a_n447_70# S0 vdd w_n460_64# pfet w=40 l=2
+  ad=0 pd=0 as=0 ps=0
M1056 gnd a_n425_n390# a_n374_n352# Gnd nfet w=20 l=2
+  ad=0 pd=0 as=120 ps=52
M1057 a_n562_72# FCin gnd Gnd nfet w=11 l=2
+  ad=0 pd=0 as=0 ps=0
M1058 a_n606_n129# FCin a_n606_n168# Gnd nfet w=20 l=2
+  ad=120 pd=52 as=160 ps=56
M1059 a_n953_n272# clk a_n981_n283# Gnd nfet w=20 l=2
+  ad=120 pd=52 as=120 ps=52
M1060 a_n374_n241# clk S2_FF Gnd nfet w=20 l=2
+  ad=120 pd=52 as=100 ps=50
M1061 a_n1026_n574# B3 gnd Gnd nfet w=13 l=2
+  ad=65 pd=36 as=0 ps=0
M1062 a_n953_n218# clk FB1 Gnd nfet w=20 l=2
+  ad=120 pd=52 as=130 ps=72
M1063 a_n953_n448# clk a_n981_n459# Gnd nfet w=20 l=2
+  ad=120 pd=52 as=120 ps=52
M1064 vdd G2_Not C2_Inter_NAND w_n748_n266# pfet w=20 l=2
+  ad=0 pd=0 as=160 ps=56
M1065 gnd a_n425_n245# a_n374_n207# Gnd nfet w=20 l=2
+  ad=0 pd=0 as=120 ps=52
M1066 a_n1004_n461# a_n1026_n486# vdd w_n1039_n467# pfet w=40 l=2
+  ad=160 pd=88 as=0 ps=0
M1067 a_n447_n75# S1 vdd w_n460_n81# pfet w=40 l=2
+  ad=160 pd=88 as=0 ps=0
M1068 gnd C1_Inter_NAND a_n553_n120# Gnd nfet w=20 l=2
+  ad=0 pd=0 as=160 ps=56
M1069 gnd C3_Inter_03 a_n563_n549# Gnd nfet w=20 l=2
+  ad=0 pd=0 as=160 ps=56
M1070 C1_Inter_NAND a_n709_n79# vdd w_n746_n114# pfet w=20 l=2
+  ad=160 pd=56 as=0 ps=0
M1071 a_n526_n221# Inter_S2 gnd Gnd nfet w=11 l=2
+  ad=90 pd=56 as=0 ps=0
M1072 vdd S0_FF Loaded_S0 w_n403_7# pfet w=20 l=2
+  ad=0 pd=0 as=100 ps=50
M1073 G1_Not FA1 a_n899_n155# Gnd nfet w=40 l=2
+  ad=240 pd=92 as=320 ps=96
M1074 a_n1026_n373# B2 vdd w_n1039_n379# pfet w=40 l=2
+  ad=0 pd=0 as=0 ps=0
M1075 gnd FB3 P3_Not Gnd nfet w=40 l=2
+  ad=0 pd=0 as=320 ps=96
M1076 C2_Inter_01 a_n617_n268# gnd Gnd nfet w=11 l=2
+  ad=55 pd=32 as=0 ps=0
M1077 FB0 FA0 Inter_S0 w_n912_n43# pfet w=10 l=2
+  ad=160 pd=82 as=120 ps=64
M1078 Inter_S1 FB1 a_n899_n211# Gnd nfet w=5 l=2
+  ad=60 pd=44 as=90 ps=56
M1079 a_n1026_n549# B3 vdd w_n1039_n555# pfet w=40 l=2
+  ad=0 pd=0 as=0 ps=0
M1080 a_n425_45# clk a_n425_70# w_n460_64# pfet w=40 l=2
+  ad=200 pd=90 as=160 ps=88
M1081 C0 G0_Not vdd w_n732_n4# pfet w=20 l=2
+  ad=0 pd=0 as=0 ps=0
M1082 a_n1026_n222# clk a_n1026_n197# w_n1039_n203# pfet w=40 l=2
+  ad=200 pd=90 as=160 ps=88
M1083 C3_Inter_04 a_n563_n549# vdd w_n576_n516# pfet w=22 l=2
+  ad=110 pd=54 as=0 ps=0
M1084 a_n374_83# clk a_n402_72# Gnd nfet w=20 l=2
+  ad=120 pd=52 as=120 ps=52
M1085 a_n1004_n574# a_n1026_n574# gnd Gnd nfet w=13 l=2
+  ad=65 pd=36 as=0 ps=0
M1086 a_n735_n439# G2_Not gnd Gnd nfet w=20 l=2
+  ad=160 pd=56 as=0 ps=0
M1087 a_n1026_42# A0 gnd Gnd nfet w=13 l=2
+  ad=65 pd=36 as=0 ps=0
M1088 gnd a_n402_72# a_n374_49# Gnd nfet w=20 l=2
+  ad=0 pd=0 as=120 ps=52
M1089 S1 Inter_S1 C0 w_n576_13# pfet w=10 l=2
+  ad=60 pd=32 as=0 ps=0
M1090 C1_Inter_01 a_n606_n129# vdd w_n619_n135# pfet w=22 l=2
+  ad=110 pd=54 as=0 ps=0
M1091 a_n606_n168# C1_Inter_NOR gnd Gnd nfet w=20 l=2
+  ad=0 pd=0 as=0 ps=0
M1092 P1_Not FB1 a_n847_n136# w_n860_n142# pfet w=80 l=2
+  ad=400 pd=170 as=0 ps=0
M1093 a_n733_n147# G0_Not gnd Gnd nfet w=20 l=2
+  ad=160 pd=56 as=0 ps=0
M1094 a_n1004_n222# clk a_n1004_n197# w_n1039_n203# pfet w=40 l=2
+  ad=200 pd=90 as=160 ps=88
M1095 Inter_S1 FB1 FA1 w_n912_n217# pfet w=10 l=2
+  ad=120 pd=64 as=150 ps=80
M1096 C2_Inter_NOR P2_Not gnd Gnd nfet w=5 l=2
+  ad=40 pd=26 as=0 ps=0
M1097 gnd a_n872_160# a_n844_137# Gnd nfet w=20 l=2
+  ad=0 pd=0 as=120 ps=52
M1098 a_n669_n369# a_n711_n371# gnd Gnd nfet w=20 l=2
+  ad=160 pd=56 as=0 ps=0
M1099 a_n953_n184# clk a_n981_n195# Gnd nfet w=20 l=2
+  ad=120 pd=52 as=120 ps=52
M1100 C3 C3_Inter_02 a_n512_n471# Gnd nfet w=20 l=2
+  ad=120 pd=52 as=0 ps=0
M1101 a_n1026_n486# A3 gnd Gnd nfet w=13 l=2
+  ad=65 pd=36 as=0 ps=0
M1102 a_n953_n130# clk FA1 Gnd nfet w=20 l=2
+  ad=120 pd=52 as=100 ps=50
M1103 a_n711_n231# a_n735_n299# gnd Gnd nfet w=11 l=2
+  ad=55 pd=32 as=0 ps=0
M1104 a_n711_n371# a_n735_n439# vdd w_n748_n406# pfet w=22 l=2
+  ad=110 pd=54 as=0 ps=0
M1105 a_n953_n360# clk a_n981_n371# Gnd nfet w=20 l=2
+  ad=120 pd=52 as=120 ps=52
M1106 C3_Inter_02 C3_Inter_01 gnd Gnd nfet w=20 l=2
+  ad=160 pd=56 as=0 ps=0
M1107 a_n402_n363# a_n425_n390# vdd w_n460_n371# pfet w=20 l=2
+  ad=100 pd=50 as=0 ps=0
M1108 G1_Not FB1 vdd w_n912_n102# pfet w=40 l=2
+  ad=320 pd=96 as=0 ps=0
M1109 a_n1004_n373# a_n1026_n398# vdd w_n1039_n379# pfet w=40 l=2
+  ad=0 pd=0 as=0 ps=0
M1110 gnd P2_Not C3_Inter_NOR Gnd nfet w=5 l=2
+  ad=0 pd=0 as=40 ps=26
M1111 a_n425_70# a_n447_45# vdd w_n460_64# pfet w=40 l=2
+  ad=0 pd=0 as=0 ps=0
M1112 Inter_S1 a_n563_n5# S1 Gnd nfet w=5 l=2
+  ad=0 pd=0 as=30 ps=22
M1113 a_n899_n155# FB1 gnd Gnd nfet w=40 l=2
+  ad=0 pd=0 as=0 ps=0
M1114 a_n425_n75# a_n447_n100# vdd w_n460_n81# pfet w=40 l=2
+  ad=160 pd=88 as=0 ps=0
M1115 gnd P0_Not C1_Inter_NOR Gnd nfet w=5 l=2
+  ad=0 pd=0 as=0 ps=0
M1116 gnd a_n1004_42# a_n953_80# Gnd nfet w=20 l=2
+  ad=0 pd=0 as=120 ps=52
M1117 P0_Not FA0 gnd Gnd nfet w=40 l=2
+  ad=320 pd=96 as=0 ps=0
M1118 a_n735_n299# P2_Not a_n735_n260# w_n748_n266# pfet w=40 l=2
+  ad=200 pd=90 as=0 ps=0
M1119 a_n1004_n549# a_n1026_n574# vdd w_n1039_n555# pfet w=40 l=2
+  ad=0 pd=0 as=0 ps=0
M1120 a_n684_n444# P3_Not vdd w_n690_n458# pfet w=10 l=2
+  ad=80 pd=36 as=0 ps=0
M1121 a_n709_n79# a_n733_n147# gnd Gnd nfet w=11 l=2
+  ad=55 pd=32 as=0 ps=0
M1122 a_n682_n152# P1_Not vdd w_n688_n166# pfet w=10 l=2
+  ad=80 pd=36 as=0 ps=0
M1123 a_n1026_n285# A2 vdd w_n1039_n291# pfet w=40 l=2
+  ad=0 pd=0 as=0 ps=0
M1124 a_n402_n218# a_n425_n245# vdd w_n460_n226# pfet w=20 l=2
+  ad=100 pd=50 as=0 ps=0
M1125 a_n505_n337# Inter_S3 vdd w_n518_n319# pfet w=22 l=2
+  ad=110 pd=54 as=0 ps=0
M1126 S3 C2 Inter_S3 w_n518_n319# pfet w=10 l=2
+  ad=60 pd=32 as=0 ps=0
M1127 P2_Not FA2 gnd Gnd nfet w=40 l=2
+  ad=320 pd=96 as=0 ps=0
M1128 gnd a_n425_n535# a_n374_n497# Gnd nfet w=20 l=2
+  ad=0 pd=0 as=120 ps=52
M1129 a_n899_n37# FA0 gnd Gnd nfet w=11 l=2
+  ad=90 pd=56 as=0 ps=0
M1130 C0 C0_Inter_01 a_n719_n37# Gnd nfet w=20 l=2
+  ad=120 pd=52 as=0 ps=0
M1131 a_n617_n268# C2_Inter_NOR vdd w_n630_n274# pfet w=20 l=2
+  ad=160 pd=56 as=0 ps=0
M1132 a_n374_n531# clk C_Out_FF Gnd nfet w=20 l=2
+  ad=0 pd=0 as=100 ps=50
M1133 a_n374_n386# clk S3_FF Gnd nfet w=20 l=2
+  ad=0 pd=0 as=100 ps=50
M1134 a_n1004_n486# a_n1026_n486# gnd Gnd nfet w=13 l=2
+  ad=65 pd=36 as=0 ps=0
M1135 a_n606_n410# C1_Inter_NAND a_n606_n449# Gnd nfet w=20 l=2
+  ad=120 pd=52 as=160 ps=56
M1136 a_n447_n100# S1 gnd Gnd nfet w=13 l=2
+  ad=65 pd=36 as=0 ps=0
M1137 gnd C_Out_FF Loaded_C_out Gnd nfet w=10 l=2
+  ad=0 pd=0 as=50 ps=30
M1138 Inter_S0 FCin S0 w_n575_90# pfet w=10 l=2
+  ad=0 pd=0 as=60 ps=32
M1139 a_n566_n253# C2_Inter_01 vdd w_n630_n274# pfet w=40 l=2
+  ad=320 pd=96 as=0 ps=0
M1140 a_n899_n211# FA1 gnd Gnd nfet w=11 l=2
+  ad=0 pd=0 as=0 ps=0
M1141 a_n1026_n398# B2 gnd Gnd nfet w=13 l=2
+  ad=65 pd=36 as=0 ps=0
M1142 Inter_S3 FB3 FA3 w_n912_n571# pfet w=10 l=2
+  ad=0 pd=0 as=150 ps=80
M1143 P3_Not FB3 a_n847_n490# w_n860_n496# pfet w=80 l=2
+  ad=400 pd=170 as=0 ps=0
M1144 G3_Not FA3 a_n899_n509# Gnd nfet w=40 l=2
+  ad=240 pd=92 as=320 ps=96
M1145 gnd S2_FF Loaded_S2 Gnd nfet w=10 l=2
+  ad=0 pd=0 as=50 ps=30
M1146 gnd a_n750_72# a_n718_41# Gnd nfet w=20 l=2
+  ad=0 pd=0 as=0 ps=0
M1147 FB0 a_n899_n37# Inter_S0 Gnd nfet w=5 l=2
+  ad=130 pd=72 as=60 ps=44
M1148 a_n1026_n134# clk a_n1026_n109# w_n1039_n115# pfet w=40 l=2
+  ad=200 pd=90 as=160 ps=88
M1149 FB2 FA2 Inter_S2 w_n912_n397# pfet w=10 l=2
+  ad=160 pd=82 as=0 ps=0
M1150 Inter_S3 FB3 a_n899_n565# Gnd nfet w=5 l=2
+  ad=0 pd=0 as=90 ps=56
M1151 a_n1004_42# a_n1026_42# gnd Gnd nfet w=13 l=2
+  ad=65 pd=36 as=0 ps=0
M1152 a_n899_n211# FA1 vdd w_n912_n217# pfet w=22 l=2
+  ad=110 pd=54 as=0 ps=0
M1153 a_n1026_n21# B0 vdd w_n1039_n27# pfet w=40 l=2
+  ad=160 pd=88 as=0 ps=0
M1154 a_n1004_n285# a_n1026_n310# vdd w_n1039_n291# pfet w=40 l=2
+  ad=0 pd=0 as=0 ps=0
M1155 a_n1004_n134# clk a_n1004_n109# w_n1039_n115# pfet w=40 l=2
+  ad=200 pd=90 as=160 ps=88
M1156 a_n1026_n222# B1 gnd Gnd nfet w=13 l=2
+  ad=65 pd=36 as=0 ps=0
M1157 C1 Inter_S2 S2 w_n539_n203# pfet w=10 l=2
+  ad=170 pd=86 as=0 ps=0
M1158 FB2 a_n899_n391# Inter_S2 Gnd nfet w=5 l=2
+  ad=130 pd=72 as=30 ps=22
M1159 gnd a_n981_n459# a_n953_n482# Gnd nfet w=20 l=2
+  ad=0 pd=0 as=120 ps=52
M1160 Inter_S0 FB0 FA0 w_n912_n43# pfet w=10 l=2
+  ad=0 pd=0 as=0 ps=0
M1161 gnd S1_FF Loaded_S1 Gnd nfet w=10 l=2
+  ad=0 pd=0 as=50 ps=30
M1162 a_n1026_n197# B1 vdd w_n1039_n203# pfet w=40 l=2
+  ad=0 pd=0 as=0 ps=0
M1163 a_n606_n449# C3_Inter_NOR gnd Gnd nfet w=20 l=2
+  ad=0 pd=0 as=0 ps=0
M1164 C3_Inter_01 a_n606_n410# vdd w_n619_n416# pfet w=22 l=2
+  ad=110 pd=54 as=0 ps=0
M1165 a_n750_72# FCin gnd Gnd nfet w=11 l=2
+  ad=55 pd=32 as=0 ps=0
M1166 a_n735_n299# G1_Not gnd Gnd nfet w=20 l=2
+  ad=160 pd=56 as=0 ps=0
M1167 a_n1004_n398# a_n1026_n398# gnd Gnd nfet w=13 l=2
+  ad=65 pd=36 as=0 ps=0
M1168 a_n425_n100# a_n447_n100# gnd Gnd nfet w=13 l=2
+  ad=65 pd=36 as=0 ps=0
M1169 S2 C1 a_n526_n221# Gnd nfet w=5 l=2
+  ad=30 pd=22 as=0 ps=0
M1170 a_n899_n509# FB3 gnd Gnd nfet w=40 l=2
+  ad=0 pd=0 as=0 ps=0
M1171 FA3 a_n981_n459# vdd w_n1039_n467# pfet w=20 l=2
+  ad=0 pd=0 as=0 ps=0
M1172 a_n895_158# a_n917_133# vdd w_n930_152# pfet w=40 l=2
+  ad=0 pd=0 as=0 ps=0
M1173 a_n844_137# clk FCin Gnd nfet w=20 l=2
+  ad=0 pd=0 as=100 ps=50
M1174 a_n447_n390# clk a_n447_n365# w_n460_n371# pfet w=40 l=2
+  ad=200 pd=90 as=160 ps=88
M1175 a_n402_n508# a_n425_n535# vdd w_n460_n516# pfet w=20 l=2
+  ad=100 pd=50 as=0 ps=0
M1176 gnd P3_Not a_n735_n439# Gnd nfet w=20 l=2
+  ad=0 pd=0 as=0 ps=0
M1177 gnd a_n402_n73# a_n374_n96# Gnd nfet w=20 l=2
+  ad=0 pd=0 as=120 ps=52
M1178 S3 C2 a_n505_n337# Gnd nfet w=5 l=2
+  ad=0 pd=0 as=90 ps=56
M1179 gnd P1_Not a_n733_n147# Gnd nfet w=20 l=2
+  ad=0 pd=0 as=0 ps=0
M1180 a_n711_n231# a_n735_n299# vdd w_n748_n266# pfet w=22 l=2
+  ad=110 pd=54 as=0 ps=0
M1181 a_n374_n352# clk a_n402_n363# Gnd nfet w=20 l=2
+  ad=0 pd=0 as=120 ps=52
M1182 vdd G1_Not C1_Inter_NAND w_n746_n114# pfet w=20 l=2
+  ad=0 pd=0 as=0 ps=0
M1183 a_n1004_n222# a_n1026_n222# gnd Gnd nfet w=13 l=2
+  ad=65 pd=36 as=0 ps=0
M1184 a_n402_72# a_n425_45# vdd w_n460_64# pfet w=20 l=2
+  ad=100 pd=50 as=0 ps=0
M1185 S1_FF a_n402_n73# vdd w_n460_n81# pfet w=20 l=2
+  ad=100 pd=50 as=0 ps=0
M1186 gnd P1_Not C2_Inter_NOR Gnd nfet w=5 l=2
+  ad=0 pd=0 as=0 ps=0
M1187 a_n1004_n197# a_n1026_n222# vdd w_n1039_n203# pfet w=40 l=2
+  ad=0 pd=0 as=0 ps=0
M1188 a_n1004_n21# a_n1026_n46# vdd w_n1039_n27# pfet w=40 l=2
+  ad=0 pd=0 as=0 ps=0
M1189 a_n1026_n134# A1 gnd Gnd nfet w=13 l=2
+  ad=65 pd=36 as=0 ps=0
M1190 a_n669_n229# a_n711_n231# gnd Gnd nfet w=20 l=2
+  ad=160 pd=56 as=0 ps=0
M1191 a_n447_n245# clk a_n447_n220# w_n460_n226# pfet w=40 l=2
+  ad=200 pd=90 as=160 ps=88
M1192 C3_Inter_03 C1_Inter_NOR a_n603_n530# Gnd nfet w=20 l=2
+  ad=120 pd=52 as=160 ps=56
M1193 a_n899_n565# FA3 vdd w_n912_n571# pfet w=22 l=2
+  ad=110 pd=54 as=0 ps=0
M1194 gnd C3_Inter_NAND C3_Inter_02 Gnd nfet w=20 l=2
+  ad=0 pd=0 as=0 ps=0
M1195 FCin a_n872_160# vdd w_n930_152# pfet w=20 l=2
+  ad=150 pd=80 as=0 ps=0
M1196 gnd a_n981_n371# a_n953_n394# Gnd nfet w=20 l=2
+  ad=0 pd=0 as=120 ps=52
M1197 a_n1026_n310# A2 gnd Gnd nfet w=13 l=2
+  ad=65 pd=36 as=0 ps=0
M1198 a_n374_n207# clk a_n402_n218# Gnd nfet w=20 l=2
+  ad=0 pd=0 as=120 ps=52
M1199 gnd a_n1004_n46# a_n953_n8# Gnd nfet w=20 l=2
+  ad=0 pd=0 as=120 ps=52
M1200 S1 Inter_S1 a_n563_n5# Gnd nfet w=5 l=2
+  ad=0 pd=0 as=90 ps=56
M1201 a_n563_n510# a_n750_72# vdd w_n576_n516# pfet w=40 l=2
+  ad=320 pd=96 as=0 ps=0
M1202 gnd a_n981_n547# a_n953_n570# Gnd nfet w=20 l=2
+  ad=0 pd=0 as=120 ps=52
M1203 a_n899_n565# FA3 gnd Gnd nfet w=11 l=2
+  ad=0 pd=0 as=0 ps=0
M1204 vdd FA3 G3_Not w_n912_n456# pfet w=40 l=2
+  ad=0 pd=0 as=320 ps=96
M1205 a_n847_n316# FA2 vdd w_n860_n322# pfet w=80 l=2
+  ad=640 pd=176 as=0 ps=0
M1206 C3_Inter_NAND G3_Not a_n669_n369# Gnd nfet w=20 l=2
+  ad=120 pd=52 as=0 ps=0
M1207 a_n425_n390# clk a_n425_n365# w_n460_n371# pfet w=40 l=2
+  ad=200 pd=90 as=160 ps=88
M1208 a_n684_n304# P2_Not vdd w_n690_n318# pfet w=10 l=2
+  ad=80 pd=36 as=0 ps=0
M1209 a_n1026_n46# B0 gnd Gnd nfet w=13 l=2
+  ad=65 pd=36 as=0 ps=0
M1210 gnd FB2 P2_Not Gnd nfet w=40 l=2
+  ad=0 pd=0 as=0 ps=0
M1211 a_n917_133# Cin gnd Gnd nfet w=13 l=2
+  ad=65 pd=36 as=0 ps=0
M1212 a_n553_n81# C1_Inter_01 vdd w_n566_n87# pfet w=40 l=2
+  ad=320 pd=96 as=0 ps=0
M1213 vdd C0 a_n617_n268# w_n630_n274# pfet w=20 l=2
+  ad=0 pd=0 as=0 ps=0
M1214 FB2 a_n981_n371# vdd w_n1039_n379# pfet w=20 l=2
+  ad=0 pd=0 as=0 ps=0
M1215 a_n750_72# FCin vdd w_n763_89# pfet w=22 l=2
+  ad=110 pd=54 as=0 ps=0
M1216 a_n1026_n109# A1 vdd w_n1039_n115# pfet w=40 l=2
+  ad=0 pd=0 as=0 ps=0
M1217 FB3 a_n981_n547# vdd w_n1039_n555# pfet w=20 l=2
+  ad=0 pd=0 as=0 ps=0
M1218 gnd FB0 P0_Not Gnd nfet w=40 l=2
+  ad=0 pd=0 as=0 ps=0
M1219 C3_Inter_NAND a_n711_n371# vdd w_n748_n406# pfet w=20 l=2
+  ad=160 pd=56 as=0 ps=0
M1220 Inter_S0 a_n562_72# S0 Gnd nfet w=5 l=2
+  ad=0 pd=0 as=0 ps=0
M1221 a_n1004_n134# a_n1026_n134# gnd Gnd nfet w=13 l=2
+  ad=65 pd=36 as=0 ps=0
M1222 a_n566_n292# C2_Inter_NAND a_n566_n253# w_n630_n274# pfet w=40 l=2
+  ad=200 pd=90 as=0 ps=0
M1223 a_n425_n245# clk a_n425_n220# w_n460_n226# pfet w=40 l=2
+  ad=200 pd=90 as=160 ps=88
M1224 C3_Inter_NOR P2_Not a_n684_n444# w_n690_n458# pfet w=10 l=2
+  ad=50 pd=30 as=0 ps=0
M1225 C1_Inter_NOR P0_Not a_n682_n152# w_n688_n166# pfet w=10 l=2
+  ad=50 pd=30 as=0 ps=0
M1226 a_n374_49# clk S0_FF Gnd nfet w=20 l=2
+  ad=0 pd=0 as=100 ps=50
M1227 a_n1004_n310# a_n1026_n310# gnd Gnd nfet w=13 l=2
+  ad=65 pd=36 as=0 ps=0
M1228 a_n603_n530# C3_Inter_NOR gnd Gnd nfet w=20 l=2
+  ad=0 pd=0 as=0 ps=0
M1229 gnd S3_FF Loaded_S3 Gnd nfet w=10 l=2
+  ad=0 pd=0 as=50 ps=30
M1230 gnd S0_FF Loaded_S0 Gnd nfet w=10 l=2
+  ad=0 pd=0 as=50 ps=30
M1231 gnd a_n425_n100# a_n374_n62# Gnd nfet w=20 l=2
+  ad=0 pd=0 as=120 ps=52
M1232 C3 C3_Inter_04 vdd w_n525_n438# pfet w=20 l=2
+  ad=160 pd=56 as=0 ps=0
M1233 G3_Not FB3 vdd w_n912_n456# pfet w=40 l=2
+  ad=0 pd=0 as=0 ps=0
M1234 a_n917_133# clk a_n917_158# w_n930_152# pfet w=40 l=2
+  ad=200 pd=90 as=0 ps=0
M1235 G0_Not FA0 a_n899_19# Gnd nfet w=40 l=2
+  ad=240 pd=92 as=320 ps=96
M1236 gnd a_n981_n19# a_n953_n42# Gnd nfet w=20 l=2
+  ad=0 pd=0 as=120 ps=52
M1237 a_n899_19# FB0 gnd Gnd nfet w=40 l=2
+  ad=0 pd=0 as=0 ps=0
M1238 a_n402_n73# a_n425_n100# vdd w_n460_n81# pfet w=20 l=2
+  ad=100 pd=50 as=0 ps=0
M1239 a_n447_n245# S2 gnd Gnd nfet w=13 l=2
+  ad=65 pd=36 as=0 ps=0
M1240 FB0 a_n981_n19# vdd w_n1039_n27# pfet w=20 l=2
+  ad=0 pd=0 as=0 ps=0
M1241 a_n1004_n109# a_n1026_n134# vdd w_n1039_n115# pfet w=40 l=2
+  ad=0 pd=0 as=0 ps=0
M1242 a_n953_80# clk a_n981_69# Gnd nfet w=20 l=2
+  ad=0 pd=0 as=120 ps=52
M1243 a_n1004_n46# a_n1026_n46# gnd Gnd nfet w=13 l=2
+  ad=65 pd=36 as=0 ps=0
M1244 a_n447_n365# S3 vdd w_n460_n371# pfet w=40 l=2
+  ad=0 pd=0 as=0 ps=0
M1245 a_n374_n497# clk a_n402_n508# Gnd nfet w=20 l=2
+  ad=0 pd=0 as=120 ps=52
M1246 gnd a_n981_69# a_n953_46# Gnd nfet w=20 l=2
+  ad=0 pd=0 as=0 ps=0
M1247 a_n374_n96# clk S1_FF Gnd nfet w=20 l=2
+  ad=0 pd=0 as=100 ps=50
M1248 gnd a_n981_n283# a_n953_n306# Gnd nfet w=20 l=2
+  ad=0 pd=0 as=0 ps=0
M1249 gnd a_n1004_n574# a_n953_n536# Gnd nfet w=20 l=2
+  ad=0 pd=0 as=0 ps=0
M1250 a_n1026_42# clk a_n1026_67# w_n1039_61# pfet w=40 l=2
+  ad=200 pd=90 as=160 ps=88
M1251 gnd P2_Not a_n735_n299# Gnd nfet w=20 l=2
+  ad=0 pd=0 as=0 ps=0
M1252 a_n1004_42# clk a_n1004_67# w_n1039_61# pfet w=40 l=2
+  ad=200 pd=90 as=160 ps=88
M1253 a_n563_n5# C0 vdd w_n576_13# pfet w=22 l=2
+  ad=110 pd=54 as=0 ps=0
M1254 a_n667_n77# a_n709_n79# gnd Gnd nfet w=20 l=2
+  ad=0 pd=0 as=0 ps=0
M1255 a_n447_n100# clk a_n447_n75# w_n460_n81# pfet w=40 l=2
+  ad=200 pd=90 as=0 ps=0
M1256 C1_Inter_01 a_n606_n129# gnd Gnd nfet w=11 l=2
+  ad=55 pd=32 as=0 ps=0
M1257 a_n847_38# FA0 vdd w_n860_32# pfet w=80 l=2
+  ad=0 pd=0 as=0 ps=0
M1258 a_n447_n220# S2 vdd w_n460_n226# pfet w=40 l=2
+  ad=0 pd=0 as=0 ps=0
M1259 a_n447_n535# clk a_n447_n510# w_n460_n516# pfet w=40 l=2
+  ad=200 pd=90 as=160 ps=88
M1260 G2_Not FA2 a_n899_n335# Gnd nfet w=40 l=2
+  ad=240 pd=92 as=320 ps=96
M1261 a_n425_n245# a_n447_n245# gnd Gnd nfet w=13 l=2
+  ad=65 pd=36 as=0 ps=0
M1262 a_n981_69# a_n1004_42# vdd w_n1039_61# pfet w=20 l=2
+  ad=100 pd=50 as=0 ps=0
M1263 S0 Inter_S0 FCin w_n575_90# pfet w=10 l=2
+  ad=0 pd=0 as=0 ps=0
M1264 FA2 a_n981_n283# vdd w_n1039_n291# pfet w=20 l=2
+  ad=150 pd=80 as=0 ps=0
M1265 Inter_S2 FB2 FA2 w_n912_n397# pfet w=10 l=2
+  ad=0 pd=0 as=0 ps=0
M1266 a_n981_n547# a_n1004_n574# vdd w_n1039_n555# pfet w=20 l=2
+  ad=100 pd=50 as=0 ps=0
M1267 vdd FCin a_n606_n129# w_n619_n135# pfet w=20 l=2
+  ad=0 pd=0 as=160 ps=56
M1268 a_n566_n292# C2_Inter_01 gnd Gnd nfet w=20 l=2
+  ad=0 pd=0 as=0 ps=0
M1269 Inter_S2 FB2 a_n899_n391# Gnd nfet w=5 l=2
+  ad=0 pd=0 as=90 ps=56
M1270 a_n425_n365# a_n447_n390# vdd w_n460_n371# pfet w=40 l=2
+  ad=0 pd=0 as=0 ps=0
M1271 a_n1026_67# A0 vdd w_n1039_61# pfet w=40 l=2
+  ad=0 pd=0 as=0 ps=0
M1272 Inter_S0 FB0 a_n899_n37# Gnd nfet w=5 l=2
+  ad=0 pd=0 as=0 ps=0
M1273 a_n709_n79# a_n733_n147# vdd w_n746_n114# pfet w=22 l=2
+  ad=110 pd=54 as=0 ps=0
M1274 a_n953_n482# clk FA3 Gnd nfet w=20 l=2
+  ad=0 pd=0 as=100 ps=50
M1275 C0_Inter_01 a_n718_41# gnd Gnd nfet w=11 l=2
+  ad=55 pd=32 as=0 ps=0
M1276 vdd C_Out_FF Loaded_C_out w_n403_n568# pfet w=20 l=2
+  ad=0 pd=0 as=100 ps=50
M1277 G0_Not FB0 vdd w_n912_72# pfet w=40 l=2
+  ad=320 pd=96 as=0 ps=0
M1278 vdd FA0 G0_Not w_n912_72# pfet w=40 l=2
+  ad=0 pd=0 as=0 ps=0
M1279 P1_Not FA1 gnd Gnd nfet w=40 l=2
+  ad=0 pd=0 as=0 ps=0
M1280 gnd a_n402_n218# a_n374_n241# Gnd nfet w=20 l=2
+  ad=0 pd=0 as=0 ps=0
M1281 a_n617_n307# C2_Inter_NOR gnd Gnd nfet w=20 l=2
+  ad=0 pd=0 as=0 ps=0
M1282 a_n563_n5# C0 gnd Gnd nfet w=11 l=2
+  ad=0 pd=0 as=0 ps=0
M1283 gnd a_n1004_n310# a_n953_n272# Gnd nfet w=20 l=2
+  ad=0 pd=0 as=0 ps=0
M1284 P2_Not FB2 a_n847_n316# w_n860_n322# pfet w=80 l=2
+  ad=400 pd=170 as=0 ps=0
M1285 a_n735_n400# G2_Not vdd w_n748_n406# pfet w=40 l=2
+  ad=0 pd=0 as=0 ps=0
M1286 a_n505_n337# Inter_S3 gnd Gnd nfet w=11 l=2
+  ad=0 pd=0 as=0 ps=0
M1287 a_n563_n549# C3_Inter_03 a_n563_n510# w_n576_n516# pfet w=40 l=2
+  ad=200 pd=90 as=0 ps=0
M1288 gnd a_n981_n195# a_n953_n218# Gnd nfet w=20 l=2
+  ad=0 pd=0 as=0 ps=0
M1289 vdd S2_FF Loaded_S2 w_n403_n283# pfet w=20 l=2
+  ad=0 pd=0 as=100 ps=50
M1290 a_n425_n220# a_n447_n245# vdd w_n460_n226# pfet w=40 l=2
+  ad=0 pd=0 as=0 ps=0
M1291 C2 a_n566_n292# gnd Gnd nfet w=11 l=2
+  ad=0 pd=0 as=0 ps=0
M1292 a_n425_n535# clk a_n425_n510# w_n460_n516# pfet w=40 l=2
+  ad=200 pd=90 as=0 ps=0
M1293 gnd a_n1004_n486# a_n953_n448# Gnd nfet w=20 l=2
+  ad=0 pd=0 as=0 ps=0
M1294 a_n425_n100# clk a_n425_n75# w_n460_n81# pfet w=40 l=2
+  ad=200 pd=90 as=0 ps=0
M1295 C2_Inter_NOR P1_Not a_n684_n304# w_n690_n318# pfet w=10 l=2
+  ad=50 pd=30 as=0 ps=0
M1296 a_n899_n37# FA0 vdd w_n912_n43# pfet w=22 l=2
+  ad=110 pd=54 as=0 ps=0
M1297 C2_Inter_NAND G2_Not a_n669_n229# Gnd nfet w=20 l=2
+  ad=120 pd=52 as=0 ps=0
M1298 a_n551_n366# C3_Inter_01 vdd w_n564_n372# pfet w=40 l=2
+  ad=0 pd=0 as=0 ps=0
M1299 gnd a_n425_45# a_n374_83# Gnd nfet w=20 l=2
+  ad=0 pd=0 as=0 ps=0
M1300 vdd FA1 G1_Not w_n912_n102# pfet w=40 l=2
+  ad=0 pd=0 as=0 ps=0
M1301 C1 a_n553_n120# vdd w_n566_n87# pfet w=22 l=2
+  ad=0 pd=0 as=0 ps=0
M1302 a_n899_n335# FB2 gnd Gnd nfet w=40 l=2
+  ad=0 pd=0 as=0 ps=0
M1303 vdd C1_Inter_NOR C3_Inter_03 w_n616_n497# pfet w=20 l=2
+  ad=0 pd=0 as=160 ps=56
M1304 Inter_S1 C0 S1 w_n576_13# pfet w=10 l=2
+  ad=0 pd=0 as=0 ps=0
M1305 a_n733_n108# G0_Not vdd w_n746_n114# pfet w=40 l=2
+  ad=0 pd=0 as=0 ps=0
M1306 a_n374_n62# clk a_n402_n73# Gnd nfet w=20 l=2
+  ad=0 pd=0 as=120 ps=52
M1307 a_n606_n129# C1_Inter_NOR vdd w_n619_n135# pfet w=20 l=2
+  ad=0 pd=0 as=0 ps=0
M1308 vdd S1_FF Loaded_S1 w_n403_n138# pfet w=20 l=2
+  ad=0 pd=0 as=100 ps=50
M1309 a_n981_n283# a_n1004_n310# vdd w_n1039_n291# pfet w=20 l=2
+  ad=100 pd=50 as=0 ps=0
M1310 a_n447_n390# S3 gnd Gnd nfet w=13 l=2
+  ad=65 pd=36 as=0 ps=0
M1311 a_n447_45# S0 gnd Gnd nfet w=13 l=2
+  ad=65 pd=36 as=0 ps=0
M1312 a_n953_n42# clk FB0 Gnd nfet w=20 l=2
+  ad=0 pd=0 as=0 ps=0
M1313 FB1 a_n981_n195# vdd w_n1039_n203# pfet w=20 l=2
+  ad=160 pd=82 as=0 ps=0
M1314 C1 a_n526_n221# S2 Gnd nfet w=5 l=2
+  ad=0 pd=0 as=0 ps=0
M1315 a_n447_n535# C3 gnd Gnd nfet w=13 l=2
+  ad=65 pd=36 as=0 ps=0
M1316 a_n981_n459# a_n1004_n486# vdd w_n1039_n467# pfet w=20 l=2
+  ad=100 pd=50 as=0 ps=0
M1317 gnd a_n895_133# a_n844_171# Gnd nfet w=20 l=2
+  ad=0 pd=0 as=0 ps=0
M1318 FB1 a_n899_n211# Inter_S1 Gnd nfet w=5 l=2
+  ad=0 pd=0 as=0 ps=0
M1319 C2_Inter_NAND a_n711_n231# vdd w_n748_n266# pfet w=20 l=2
+  ad=0 pd=0 as=0 ps=0
M1320 vdd C3_Inter_02 C3 w_n525_n438# pfet w=20 l=2
+  ad=0 pd=0 as=0 ps=0
M1321 a_n718_80# P0_Not vdd w_n731_74# pfet w=40 l=2
+  ad=0 pd=0 as=0 ps=0
M1322 gnd a_n1004_n134# a_n953_n96# Gnd nfet w=20 l=2
+  ad=0 pd=0 as=0 ps=0
M1323 a_n553_n120# C1_Inter_NAND a_n553_n81# w_n566_n87# pfet w=40 l=2
+  ad=200 pd=90 as=0 ps=0
M1324 a_n953_n394# clk FB2 Gnd nfet w=20 l=2
+  ad=0 pd=0 as=0 ps=0
M1325 a_n981_n107# a_n1004_n134# vdd w_n1039_n115# pfet w=20 l=2
+  ad=100 pd=50 as=0 ps=0
M1326 a_n1026_n486# clk a_n1026_n461# w_n1039_n467# pfet w=40 l=2
+  ad=200 pd=90 as=0 ps=0
M1327 FB1 FA1 Inter_S1 w_n912_n217# pfet w=10 l=2
+  ad=0 pd=0 as=0 ps=0
M1328 a_n899_n391# FA2 vdd w_n912_n397# pfet w=22 l=2
+  ad=110 pd=54 as=0 ps=0
M1329 a_n953_n570# clk FB3 Gnd nfet w=20 l=2
+  ad=0 pd=0 as=0 ps=0
M1330 S0_FF a_n402_72# vdd w_n460_64# pfet w=20 l=2
+  ad=100 pd=50 as=0 ps=0
M1331 gnd a_n1004_n222# a_n953_n184# Gnd nfet w=20 l=2
+  ad=0 pd=0 as=0 ps=0
M1332 a_n1004_n486# clk a_n1004_n461# w_n1039_n467# pfet w=40 l=2
+  ad=200 pd=90 as=0 ps=0
M1333 a_n526_n221# Inter_S2 vdd w_n539_n203# pfet w=22 l=2
+  ad=110 pd=54 as=0 ps=0
M1334 vdd G3_Not C3_Inter_NAND w_n748_n406# pfet w=20 l=2
+  ad=0 pd=0 as=0 ps=0
M1335 a_n1004_67# a_n1026_42# vdd w_n1039_61# pfet w=40 l=2
+  ad=0 pd=0 as=0 ps=0
M1336 C0_Inter_01 a_n718_41# vdd w_n731_74# pfet w=22 l=2
+  ad=110 pd=54 as=0 ps=0
M1337 gnd a_n981_n107# a_n953_n130# Gnd nfet w=20 l=2
+  ad=0 pd=0 as=0 ps=0
M1338 vdd FA2 G2_Not w_n912_n282# pfet w=40 l=2
+  ad=0 pd=0 as=0 ps=0
M1339 gnd a_n1004_n398# a_n953_n360# Gnd nfet w=20 l=2
+  ad=0 pd=0 as=0 ps=0
M1340 a_n899_n391# FA2 gnd Gnd nfet w=11 l=2
+  ad=0 pd=0 as=0 ps=0
M1341 C3_Inter_01 a_n606_n410# gnd Gnd nfet w=11 l=2
+  ad=55 pd=32 as=0 ps=0
M1342 S2_FF a_n402_n218# vdd w_n460_n226# pfet w=20 l=2
+  ad=100 pd=50 as=0 ps=0
M1343 a_n447_n510# C3 vdd w_n460_n516# pfet w=40 l=2
+  ad=0 pd=0 as=0 ps=0
M1344 a_n953_n8# clk a_n981_n19# Gnd nfet w=20 l=2
+  ad=0 pd=0 as=120 ps=52
M1345 C3_Inter_03 C3_Inter_NOR vdd w_n616_n497# pfet w=20 l=2
+  ad=0 pd=0 as=0 ps=0
M1346 a_n425_n390# a_n447_n390# gnd Gnd nfet w=13 l=2
+  ad=65 pd=36 as=0 ps=0
M1347 a_n1026_n46# clk a_n1026_n21# w_n1039_n27# pfet w=40 l=2
+  ad=200 pd=90 as=0 ps=0
M1348 a_n553_n120# C1_Inter_01 gnd Gnd nfet w=20 l=2
+  ad=0 pd=0 as=0 ps=0
M1349 a_n425_n535# a_n447_n535# gnd Gnd nfet w=13 l=2
+  ad=65 pd=36 as=0 ps=0
M1350 a_n563_n549# a_n750_72# gnd Gnd nfet w=20 l=2
+  ad=0 pd=0 as=0 ps=0
M1351 a_n895_133# a_n917_133# gnd Gnd nfet w=13 l=2
+  ad=65 pd=36 as=0 ps=0
M1352 a_n981_n195# a_n1004_n222# vdd w_n1039_n203# pfet w=20 l=2
+  ad=100 pd=50 as=0 ps=0
M1353 P3_Not FA3 gnd Gnd nfet w=40 l=2
+  ad=0 pd=0 as=0 ps=0
M1354 vdd C1_Inter_NAND a_n606_n410# w_n619_n416# pfet w=20 l=2
+  ad=0 pd=0 as=0 ps=0
M1355 FA1 a_n981_n107# vdd w_n1039_n115# pfet w=20 l=2
+  ad=0 pd=0 as=0 ps=0
M1356 C2_Inter_01 a_n617_n268# vdd w_n630_n274# pfet w=22 l=2
+  ad=110 pd=54 as=0 ps=0
M1357 C2 Inter_S3 S3 w_n518_n319# pfet w=10 l=2
+  ad=0 pd=0 as=0 ps=0
M1358 a_n981_n371# a_n1004_n398# vdd w_n1039_n379# pfet w=20 l=2
+  ad=100 pd=50 as=0 ps=0
M1359 C3_Inter_NOR P3_Not gnd Gnd nfet w=5 l=2
+  ad=0 pd=0 as=0 ps=0
C0 C1_Inter_NAND a_n553_n120# 0.19fF
C1 gnd a_n1026_n46# 0.02fF
C2 FB0 G0_Not 0.49fF
C3 P1_Not P2_Not 0.03fF
C4 clk B3 0.03fF
C5 w_n912_n571# Inter_S3 0.06fF
C6 a_n750_72# P2_Not 0.08fF
C7 w_n1039_61# vdd 0.20fF
C8 C0 C1_Inter_NAND 0.05fF
C9 G2_Not a_n735_n439# 0.02fF
C10 vdd C0_Inter_01 0.09fF
C11 w_n1039_n115# a_n981_n107# 0.15fF
C12 C3_Inter_01 a_n606_n410# 0.05fF
C13 a_n1004_n46# a_n981_n19# 0.02fF
C14 w_n616_n497# vdd 0.11fF
C15 gnd P3_Not 0.45fF
C16 FCin C0_Inter_01 0.58fF
C17 gnd a_n562_72# 0.05fF
C18 vdd a_n425_45# 0.27fF
C19 w_n746_n114# a_n733_n147# 0.09fF
C20 P2_Not FA2 0.03fF
C21 C3_Inter_01 C3_Inter_02 0.03fF
C22 w_n1039_61# a_n1026_42# 0.09fF
C23 w_n1039_n291# A2 0.06fF
C24 P0_Not a_n709_n79# 0.07fF
C25 a_n750_72# Inter_S0 0.04fF
C26 gnd a_n402_72# 0.05fF
C27 w_n912_72# G0_Not 0.15fF
C28 w_n1039_n379# a_n1004_n398# 0.23fF
C29 w_n564_n372# vdd 0.08fF
C30 vdd C1 0.06fF
C31 clk FA3 0.00fF
C32 w_n688_n166# P0_Not 0.06fF
C33 gnd FB3 0.13fF
C34 w_n912_n282# FB2 0.06fF
C35 vdd a_n981_n107# 0.04fF
C36 FB1 a_n899_n211# 0.17fF
C37 vdd Inter_S3 0.03fF
C38 w_n576_n516# a_n750_72# 0.06fF
C39 C1_Inter_NAND C3_Inter_NAND 0.04fF
C40 vdd a_n981_n547# 0.04fF
C41 w_n1039_n467# clk 0.33fF
C42 w_n630_n274# vdd 0.21fF
C43 w_n403_n138# Loaded_S1 0.02fF
C44 G2_Not a_n735_n260# 0.01fF
C45 w_n630_n274# C2_Inter_01 0.10fF
C46 vdd C1_Inter_NOR 0.24fF
C47 P2_Not a_n735_n439# 0.02fF
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
