IamSid44/VLSI-Project/Static Implementation/MAGIC/CLA/CLA.cir

* Extracted Netlist
.include TSMC_180nm.txt
.param SUPPLY=1.8
.global gnd vdd

* Supply
Vdd vdd gnd 'SUPPLY'

* SPICE3 file created from CLA.ext - technology: scmos

.option scale=0.09u

M1000 gnd a_123_n363# C1 Gnd CMOSN w=11 l=2
+  ad=4886 pd=2452 as=55 ps=32
M1001 a_176_n397# a_134_n399# gnd Gnd CMOSN w=20 l=2
+  ad=160 pd=56 as=0 ps=0
M1002 C3_Inter_NAND G2_Not a_176_n561# Gnd CMOSN w=20 l=2
+  ad=120 pd=52 as=160 ps=56
M1003 G1_Not A1 a_24_n316# Gnd CMOSN w=40 l=2
+  ad=240 pd=92 as=320 ps=96
M1004 a_76_n625# A3 vdd w_63_n631# CMOSP w=80 l=2
+  ad=640 pd=176 as=6960 ps=3224
M1005 G3_Not B3 vdd w_11_n591# CMOSP w=40 l=2
+  ad=320 pd=96 as=0 ps=0
M1006 C3_Inter_NOR P3_Not gnd Gnd CMOSN w=5 l=2
+  ad=40 pd=26 as=0 ps=0
M1007 a_188_n470# C2_Inter_NOR vdd w_63_n631# CMOSP w=20 l=2
+  ad=160 pd=56 as=0 ps=0
M1008 a_24_n536# A2 gnd Gnd CMOSN w=11 l=2
+  ad=90 pd=56 as=0 ps=0
M1009 a_188_n431# C2_Inter_NOR gnd Gnd CMOSN w=20 l=2
+  ad=160 pd=56 as=0 ps=0
M1010 B0 A0 Inter_S0 w_11_n263# CMOSP w=10 l=2
+  ad=60 pd=32 as=60 ps=32
M1011 gnd B0 P0_Not Gnd CMOSN w=40 l=2
+  ad=0 pd=0 as=320 ps=96
M1012 a_110_n303# P1_Not a_110_n264# w_63_n303# CMOSP w=40 l=2
+  ad=200 pd=90 as=320 ps=96
M1013 G0_Not B0 vdd w_11_n99# CMOSP w=40 l=2
+  ad=320 pd=96 as=0 ps=0
M1014 C3_Inter_NAND a_134_n563# vdd w_63_n631# CMOSP w=20 l=2
+  ad=160 pd=56 as=0 ps=0
M1015 gnd P3_Not a_110_n631# Gnd CMOSN w=20 l=2
+  ad=0 pd=0 as=160 ps=56
M1016 Inter_S2 B2 A2 w_11_n591# CMOSP w=10 l=2
+  ad=60 pd=32 as=50 ps=30
M1017 a_134_n399# a_110_n467# vdd w_63_n467# CMOSP w=22 l=2
+  ad=110 pd=54 as=0 ps=0
M1018 G0_Not A0 a_24_n152# Gnd CMOSN w=40 l=2
+  ad=240 pd=92 as=320 ps=96
M1019 a_76_n461# A2 vdd w_63_n467# CMOSP w=80 l=2
+  ad=640 pd=176 as=0 ps=0
M1020 a_188_n306# Cin a_188_n267# Gnd CMOSN w=20 l=2
+  ad=120 pd=52 as=160 ps=56
M1021 vdd C0_Inter_01 C0 w_103_n173# CMOSP w=20 l=2
+  ad=0 pd=0 as=160 ps=56
M1022 a_176_n233# a_134_n235# gnd Gnd CMOSN w=20 l=2
+  ad=160 pd=56 as=0 ps=0
M1023 G2_Not B2 vdd w_11_n427# CMOSP w=40 l=2
+  ad=320 pd=96 as=0 ps=0
M1024 vdd C1_Inter_NAND a_151_n345# w_63_n467# CMOSP w=20 l=2
+  ad=0 pd=0 as=160 ps=56
M1025 Inter_S1 B1 A1 w_11_n427# CMOSP w=10 l=2
+  ad=60 pd=32 as=50 ps=30
M1026 a_134_n235# a_110_n303# vdd w_63_n303# CMOSP w=22 l=2
+  ad=110 pd=54 as=0 ps=0
M1027 a_24_n700# A3 vdd w_11_n706# CMOSP w=22 l=2
+  ad=110 pd=54 as=0 ps=0
M1028 a_188_n306# C1_inter_NOR vdd w_63_n467# CMOSP w=20 l=2
+  ad=160 pd=56 as=0 ps=0
M1029 P1_Not B1 a_76_n297# w_63_n303# CMOSP w=80 l=2
+  ad=400 pd=170 as=640 ps=176
M1030 P2_Not A2 gnd Gnd CMOSN w=40 l=2
+  ad=320 pd=96 as=0 ps=0
M1031 a_24_n480# B2 gnd Gnd CMOSN w=40 l=2
+  ad=320 pd=96 as=0 ps=0
M1032 Inter_S1 B1 a_24_n372# Gnd CMOSN w=5 l=2
+  ad=30 pd=22 as=90 ps=56
M1033 C1_inter_NOR P0_Not a_161_n308# w_63_n467# CMOSP w=15 l=2
+  ad=75 pd=40 as=120 ps=46
M1034 a_110_n132# P0_Not gnd Gnd CMOSN w=20 l=2
+  ad=160 pd=56 as=0 ps=0
M1035 vdd A1 G1_Not w_11_n263# CMOSP w=40 l=2
+  ad=0 pd=0 as=320 ps=96
M1036 a_110_n93# P0_Not vdd w_63_n139# CMOSP w=40 l=2
+  ad=320 pd=96 as=0 ps=0
M1037 gnd P0_Not C1_inter_NOR Gnd CMOSN w=10 l=2
+  ad=0 pd=0 as=80 ps=36
M1038 P1_Not A1 gnd Gnd CMOSN w=40 l=2
+  ad=320 pd=96 as=0 ps=0
M1039 Inter_S0 B0 a_24_n208# Gnd CMOSN w=5 l=2
+  ad=30 pd=22 as=90 ps=56
M1040 vdd a_122_n509# C2 w_63_n631# CMOSP w=22 l=2
+  ad=0 pd=0 as=110 ps=54
M1041 a_110_n428# G2_Not vdd w_63_n467# CMOSP w=40 l=2
+  ad=320 pd=96 as=0 ps=0
M1042 a_24_n536# A2 vdd w_11_n591# CMOSP w=22 l=2
+  ad=110 pd=54 as=0 ps=0
M1043 P0_Not B0 a_76_n133# w_63_n139# CMOSP w=80 l=2
+  ad=400 pd=170 as=640 ps=176
M1044 a_24_n316# B1 gnd Gnd CMOSN w=40 l=2
+  ad=0 pd=0 as=0 ps=0
M1045 a_122_n509# a_118_n511# gnd Gnd CMOSN w=10 l=2
+  ad=80 pd=36 as=0 ps=0
M1046 P0_Not A0 gnd Gnd CMOSN w=40 l=2
+  ad=0 pd=0 as=0 ps=0
M1047 a_110_n264# G1_Not vdd w_63_n303# CMOSP w=40 l=2
+  ad=0 pd=0 as=0 ps=0
M1048 vdd a_123_n363# C1 w_63_n467# CMOSP w=22 l=2
+  ad=0 pd=0 as=110 ps=54
M1049 a_110_n631# G3_Not gnd Gnd CMOSN w=20 l=2
+  ad=0 pd=0 as=0 ps=0
M1050 C2_Inter_01 a_188_n470# gnd Gnd CMOSN w=11 l=2
+  ad=55 pd=32 as=0 ps=0
M1051 C2_Inter_NAND G1_Not a_176_n397# Gnd CMOSN w=20 l=2
+  ad=120 pd=52 as=0 ps=0
M1052 B3 A3 Inter_S3 w_11_n706# CMOSP w=10 l=2
+  ad=60 pd=32 as=60 ps=32
M1053 a_24_n372# A1 vdd w_11_n427# CMOSP w=22 l=2
+  ad=110 pd=54 as=0 ps=0
M1054 a_24_n152# B0 gnd Gnd CMOSN w=40 l=2
+  ad=0 pd=0 as=0 ps=0
M1055 B3 a_24_n700# Inter_S3 Gnd CMOSN w=5 l=2
+  ad=30 pd=22 as=30 ps=22
M1056 gnd P2_Not C3_Inter_NOR Gnd CMOSN w=5 l=2
+  ad=0 pd=0 as=0 ps=0
M1057 a_24_n372# A1 gnd Gnd CMOSN w=11 l=2
+  ad=0 pd=0 as=0 ps=0
M1058 a_188_n267# C1_inter_NOR gnd Gnd CMOSN w=20 l=2
+  ad=0 pd=0 as=0 ps=0
M1059 C0 G0_Not vdd w_103_n173# CMOSP w=20 l=2
+  ad=0 pd=0 as=0 ps=0
M1060 vdd G2_Not C3_Inter_NAND w_63_n631# CMOSP w=20 l=2
+  ad=0 pd=0 as=0 ps=0
M1061 C2_Inter_NAND a_134_n399# vdd w_63_n467# CMOSP w=20 l=2
+  ad=160 pd=56 as=0 ps=0
M1062 gnd P2_Not a_110_n467# Gnd CMOSN w=20 l=2
+  ad=0 pd=0 as=160 ps=56
M1063 C1_inter_01 a_188_n306# gnd Gnd CMOSN w=11 l=2
+  ad=55 pd=32 as=0 ps=0
M1064 a_76_n297# A1 vdd w_63_n303# CMOSP w=80 l=2
+  ad=0 pd=0 as=0 ps=0
M1065 a_24_n208# A0 gnd Gnd CMOSN w=11 l=2
+  ad=0 pd=0 as=0 ps=0
M1066 C0_Inter_01 a_110_n132# gnd Gnd CMOSN w=11 l=2
+  ad=55 pd=32 as=0 ps=0
M1067 C1_Inter_NAND G0_Not a_176_n233# Gnd CMOSN w=20 l=2
+  ad=120 pd=52 as=0 ps=0
M1068 Inter_S0 B0 A0 w_11_n263# CMOSP w=10 l=2
+  ad=0 pd=0 as=50 ps=30
M1069 G1_Not B1 vdd w_11_n263# CMOSP w=40 l=2
+  ad=0 pd=0 as=0 ps=0
M1070 B2 a_24_n536# Inter_S2 Gnd CMOSN w=5 l=2
+  ad=30 pd=22 as=30 ps=22
M1071 C1_Inter_NAND a_134_n235# vdd w_63_n303# CMOSP w=20 l=2
+  ad=160 pd=56 as=0 ps=0
M1072 a_161_n636# P3_Not vdd w_155_n650# CMOSP w=10 l=2
+  ad=80 pd=36 as=0 ps=0
M1073 gnd P1_Not a_110_n303# Gnd CMOSN w=20 l=2
+  ad=0 pd=0 as=160 ps=56
M1074 a_76_n133# A0 vdd w_63_n139# CMOSP w=80 l=2
+  ad=0 pd=0 as=0 ps=0
M1075 a_151_n509# a_118_n511# a_122_n509# w_63_n631# CMOSP w=20 l=2
+  ad=160 pd=56 as=100 ps=50
M1076 C2_Inter_01 a_188_n470# vdd w_63_n631# CMOSP w=22 l=2
+  ad=110 pd=54 as=0 ps=0
M1077 a_161_n472# P2_Not vdd w_63_n631# CMOSP w=15 l=2
+  ad=120 pd=46 as=0 ps=0
M1078 C0 C0_Inter_01 a_116_n206# Gnd CMOSN w=20 l=2
+  ad=120 pd=52 as=160 ps=56
M1079 a_134_n563# a_110_n631# gnd Gnd CMOSN w=11 l=2
+  ad=55 pd=32 as=0 ps=0
M1080 gnd B3 P3_Not Gnd CMOSN w=40 l=2
+  ad=0 pd=0 as=320 ps=96
M1081 Intermediate a_118_n347# gnd Gnd CMOSN w=10 l=2
+  ad=80 pd=36 as=0 ps=0
M1082 gnd C2_Inter_NAND a_122_n509# Gnd CMOSN w=10 l=2
+  ad=0 pd=0 as=0 ps=0
M1083 C2_Inter_NOR P2_Not gnd Gnd CMOSN w=10 l=2
+  ad=80 pd=36 as=0 ps=0
M1084 G3_Not A3 a_24_n644# Gnd CMOSN w=40 l=2
+  ad=240 pd=92 as=320 ps=96
M1085 a_110_n467# G2_Not gnd Gnd CMOSN w=20 l=2
+  ad=0 pd=0 as=0 ps=0
M1086 a_110_n631# P3_Not a_110_n592# w_63_n631# CMOSP w=40 l=2
+  ad=200 pd=90 as=320 ps=96
M1087 a_134_n399# a_110_n467# gnd Gnd CMOSN w=11 l=2
+  ad=55 pd=32 as=0 ps=0
M1088 C1_inter_01 a_188_n306# vdd w_63_n467# CMOSP w=22 l=2
+  ad=110 pd=54 as=0 ps=0
M1089 vdd G1_Not C2_Inter_NAND w_63_n467# CMOSP w=20 l=2
+  ad=0 pd=0 as=0 ps=0
M1090 a_24_n208# A0 vdd w_11_n263# CMOSP w=22 l=2
+  ad=110 pd=54 as=0 ps=0
M1091 B2 A2 Inter_S2 w_11_n591# CMOSP w=10 l=2
+  ad=60 pd=32 as=0 ps=0
M1092 a_176_n561# a_134_n563# gnd Gnd CMOSN w=20 l=2
+  ad=0 pd=0 as=0 ps=0
M1093 C0_Inter_01 a_110_n132# vdd w_63_n139# CMOSP w=22 l=2
+  ad=110 pd=54 as=0 ps=0
M1094 Inter_S3 B3 A3 w_11_n706# CMOSP w=10 l=2
+  ad=0 pd=0 as=50 ps=30
M1095 a_134_n563# a_110_n631# vdd w_63_n631# CMOSP w=22 l=2
+  ad=110 pd=54 as=0 ps=0
M1096 a_110_n303# G1_Not gnd Gnd CMOSN w=20 l=2
+  ad=0 pd=0 as=0 ps=0
M1097 Inter_S3 B3 a_24_n700# Gnd CMOSN w=5 l=2
+  ad=0 pd=0 as=90 ps=56
M1098 B1 A1 Inter_S1 w_11_n427# CMOSP w=10 l=2
+  ad=60 pd=32 as=0 ps=0
M1099 vdd A0 G0_Not w_11_n99# CMOSP w=40 l=2
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
