IamSid44/VLSI-Project/Static Implementation/FPGA/CLA_4_Bit.srcs/constrs_1/new/CLA_Constraint_File.xdc

set_property CFGBVS VCCO [current_design]
set_property CONFIG_VOLTAGE 3.3 [current_design]
set_property CLOCK_DEDICATED_ROUTE FALSE [get_nets Clk_IBUF]

# On-board Slide Switches
#set_property -dict {PACKAGE_PIN V2 IOSTANDARD LVCMOS33} [get_ports {Rst}]
set_property -dict {PACKAGE_PIN U2 IOSTANDARD LVCMOS33} [get_ports {Clk}]
#set_property -dict {PACKAGE_PIN U1 IOSTANDARD LVCMOS33} [get_ports {A[0]}]
set_property -dict {PACKAGE_PIN T2 IOSTANDARD LVCMOS33} [get_ports {Rst}]
#set_property -dict {PACKAGE_PIN T1 IOSTANDARD LVCMOS33} [get_ports {A[2]}]
set_property -dict {PACKAGE_PIN R2 IOSTANDARD LVCMOS33} [get_ports {Cin}]
#set_property -dict {PACKAGE_PIN R1 IOSTANDARD LVCMOS33} [get_ports {B[0]}]
set_property -dict {PACKAGE_PIN P2 IOSTANDARD LVCMOS33} [get_ports {A[0]}]
set_property -dict {PACKAGE_PIN P1 IOSTANDARD LVCMOS33} [get_ports {A[1]}]
set_property -dict {PACKAGE_PIN N2 IOSTANDARD LVCMOS33} [get_ports {A[2]}]
set_property -dict {PACKAGE_PIN N1 IOSTANDARD LVCMOS33} [get_ports {A[3]}]
#set_property -dict {PACKAGE_PIN M2 IOSTANDARD LVCMOS33} [get_ports {Y[2]}]
set_property -dict {PACKAGE_PIN M1 IOSTANDARD LVCMOS33} [get_ports {B[0]}]
set_property -dict {PACKAGE_PIN L1 IOSTANDARD LVCMOS33} [get_ports {B[1]}]
set_property -dict {PACKAGE_PIN K2 IOSTANDARD LVCMOS33} [get_ports {B[2]}]
set_property -dict {PACKAGE_PIN K1 IOSTANDARD LVCMOS33} [get_ports {B[3]}]

# PMOD Output
set_property -dict {PACKAGE_PIN B13 IOSTANDARD LVCMOS33} [get_ports {S[0]}]
set_property -dict {PACKAGE_PIN A14 IOSTANDARD LVCMOS33} [get_ports {S[1]}]
set_property -dict {PACKAGE_PIN B15 IOSTANDARD LVCMOS33} [get_ports {S[2]}]
set_property -dict {PACKAGE_PIN A15 IOSTANDARD LVCMOS33} [get_ports {S[3]}]
set_property -dict {PACKAGE_PIN B14 IOSTANDARD LVCMOS33} [get_ports {Cout}]

# On-board LEDs
#set_property -dict {PACKAGE_PIN G1 IOSTANDARD LVCMOS33} [get_ports {S[0]}]
#set_property -dict {PACKAGE_PIN G2 IOSTANDARD LVCMOS33} [get_ports {S[1]}]
#set_property -dict {PACKAGE_PIN F1 IOSTANDARD LVCMOS33} [get_ports {S[2]}]
#set_property -dict {PACKAGE_PIN F2 IOSTANDARD LVCMOS33} [get_ports {S[3]}]
#set_property -dict {PACKAGE_PIN E1 IOSTANDARD LVCMOS33} [get_ports {Cout}]
#set_property -dict {PACKAGE_PIN E2 IOSTANDARD LVCMOS33} [get_ports {Z[5]}]
set_property -dict {PACKAGE_PIN E3 IOSTANDARD LVCMOS33} [get_ports {Ain[0]}]
set_property -dict {PACKAGE_PIN E5 IOSTANDARD LVCMOS33} [get_ports {Ain[1]}]
set_property -dict {PACKAGE_PIN E6 IOSTANDARD LVCMOS33} [get_ports {Ain[2]}]
set_property -dict {PACKAGE_PIN C3 IOSTANDARD LVCMOS33} [get_ports {Ain[3]}]
#set_property -dict {PACKAGE_PIN B2 IOSTANDARD LVCMOS33} [get_ports {Xval[1]}]
set_property -dict {PACKAGE_PIN A2 IOSTANDARD LVCMOS33} [get_ports {Bin[0]}]
set_property -dict {PACKAGE_PIN B3 IOSTANDARD LVCMOS33} [get_ports {Bin[1]}]
set_property -dict {PACKAGE_PIN A3 IOSTANDARD LVCMOS33} [get_ports {Bin[2]}]
set_property -dict {PACKAGE_PIN B4 IOSTANDARD LVCMOS33} [get_ports {Bin[3]}]
set_property -dict {PACKAGE_PIN A4 IOSTANDARD LVCMOS33} [get_ports {Cin_in}]

# On-board Buttons
#set_property -dict {PACKAGE_PIN J2 IOSTANDARD LVCMOS33} [get_ports {btn[0]}]
#set_property -dict {PACKAGE_PIN J5 IOSTANDARD LVCMOS33} [get_ports {Clk}]
#set_property -dict {PACKAGE_PIN H2 IOSTANDARD LVCMOS33} [get_ports {Clr}]
#set_property -dict {PACKAGE_PIN J1 IOSTANDARD LVCMOS33} [get_ports {btn[1]}]

# On-board color LEDs
#set_property -dict {PACKAGE_PIN V6 IOSTANDARD LVCMOS33} [get_ports {RGB0[0]}];   # RBG0_R
#set_property -dict {PACKAGE_PIN V4 IOSTANDARD LVCMOS33} [get_ports {RGB0[1]}];   # RBG0_G
#set_property -dict {PACKAGE_PIN U6 IOSTANDARD LVCMOS33} [get_ports {RGB0[2]}];   # RBG0_B
#set_property -dict {PACKAGE_PIN U3 IOSTANDARD LVCMOS33} [get_ports {RGB1[0]}];   # RBG1_R
#set_property -dict {PACKAGE_PIN V3 IOSTANDARD LVCMOS33} [get_ports {RGB1[1]}];   # RBG1_G
#set_property -dict {PACKAGE_PIN V5 IOSTANDARD LVCMOS33} [get_ports {RGB1[2]}];   # RBG1_B

# On-board 7-Segment display 0
#set_property -dict {PACKAGE_PIN D5 IOSTANDARD LVCMOS33} [get_ports {D0_AN[0]}]
#set_property -dict {PACKAGE_PIN C4 IOSTANDARD LVCMOS33} [get_ports {D0_AN[1]}]
#set_property -dict {PACKAGE_PIN C7 IOSTANDARD LVCMOS33} [get_ports {D0_AN[2]}]
#set_property -dict {PACKAGE_PIN A8 IOSTANDARD LVCMOS33} [get_ports {D0_AN[3]}]
#set_property -dict {PACKAGE_PIN D7 IOSTANDARD LVCMOS33} [get_ports {D0_SEG[0]}]
#set_property -dict {PACKAGE_PIN C5 IOSTANDARD LVCMOS33} [get_ports {D0_SEG[1]}]
#set_property -dict {PACKAGE_PIN A5 IOSTANDARD LVCMOS33} [get_ports {D0_SEG[2]}]
#set_property -dict {PACKAGE_PIN B7 IOSTANDARD LVCMOS33} [get_ports {D0_SEG[3]}]
#set_property -dict {PACKAGE_PIN A7 IOSTANDARD LVCMOS33} [get_ports {D0_SEG[4]}]
#set_property -dict {PACKAGE_PIN D6 IOSTANDARD LVCMOS33} [get_ports {D0_SEG[5]}]
#set_property -dict {PACKAGE_PIN B5 IOSTANDARD LVCMOS33} [get_ports {D0_SEG[6]}]
#set_property -dict {PACKAGE_PIN A6 IOSTANDARD LVCMOS33} [get_ports {D0_SEG[7]}]

# On-board 7-Segment display 1
#set_property -dict {PACKAGE_PIN H3 IOSTANDARD LVCMOS33} [get_ports {D1_AN[0]}]
#set_property -dict {PACKAGE_PIN J4 IOSTANDARD LVCMOS33} [get_ports {D1_AN[1]}]
#set_property -dict {PACKAGE_PIN F3 IOSTANDARD LVCMOS33} [get_ports {D1_AN[2]}]
#set_property -dict {PACKAGE_PIN E4 IOSTANDARD LVCMOS33} [get_ports {D1_AN[3]}]
#set_property -dict {PACKAGE_PIN F4 IOSTANDARD LVCMOS33} [get_ports {D1_SEG[0]}]
#set_property -dict {PACKAGE_PIN J3 IOSTANDARD LVCMOS33} [get_ports {D1_SEG[1]}]
#set_property -dict {PACKAGE_PIN D2 IOSTANDARD LVCMOS33} [get_ports {D1_SEG[2]}]
#set_property -dict {PACKAGE_PIN C2 IOSTANDARD LVCMOS33} [get_ports {D1_SEG[3]}]
#set_property -dict {PACKAGE_PIN B1 IOSTANDARD LVCMOS33} [get_ports {D1_SEG[4]}]
#set_property -dict {PACKAGE_PIN H4 IOSTANDARD LVCMOS33} [get_ports {D1_SEG[5]}]
#set_property -dict {PACKAGE_PIN D1 IOSTANDARD LVCMOS33} [get_ports {D1_SEG[6]}]
#set_property -dict {PACKAGE_PIN C1 IOSTANDARD LVCMOS33} [get_ports {D1_SEG[7]}]

# UART
#set_property -dict {PACKAGE_PIN V12 IOSTANDARD LVCMOS33} [get_ports {UART_rxd}]
#set_property -dict {PACKAGE_PIN U11 IOSTANDARD LVCMOS33} [get_ports {UART_txd}]

#HDMI Signals
#set_property -dict { PACKAGE_PIN T14   IOSTANDARD TMDS_33 } [get_ports {hdmi_clk_n}]
#set_property -dict { PACKAGE_PIN R14   IOSTANDARD TMDS_33 } [get_ports {hdmi_clk_p}]

#set_property -dict { PACKAGE_PIN T15   IOSTANDARD TMDS_33  } [get_ports {hdmi_tx_n[0]}]
#set_property -dict { PACKAGE_PIN R17   IOSTANDARD TMDS_33  } [get_ports {hdmi_tx_n[1]}]
#set_property -dict { PACKAGE_PIN P16   IOSTANDARD TMDS_33  } [get_ports {hdmi_tx_n[2]}]
                                    
#set_property -dict { PACKAGE_PIN R15   IOSTANDARD TMDS_33  } [get_ports {hdmi_tx_p[0]}]
#set_property -dict { PACKAGE_PIN R16   IOSTANDARD TMDS_33  } [get_ports {hdmi_tx_p[1]}]
#set_property -dict { PACKAGE_PIN N15   IOSTANDARD TMDS_33  } [get_ports {hdmi_tx_p[2]}]

# PWM audio signals
#set_property -dict {PACKAGE_PIN N13 IOSTANDARD LVCMOS33} [get_ports {left_audio_out}]
#set_property -dict {PACKAGE_PIN N14 IOSTANDARD LVCMOS33} [get_ports {right_audio_out}]

# BLE UART signals
#set_property -dict {PACKAGE_PIN G5 IOSTANDARD LVCMOS33} [get_ports {ble_uart_tx}]
#set_property -dict {PACKAGE_PIN F5 IOSTANDARD LVCMOS33} [get_ports {ble_uart_rx}]
#set_property -dict {PACKAGE_PIN H6 IOSTANDARD LVCMOS33} [get_ports {ble_uart_rts}]
#set_property -dict {PACKAGE_PIN G6 IOSTANDARD LVCMOS33} [get_ports {ble_uart_cts}]

# Servomotor signals
#set_property -dict {PACKAGE_PIN M14 IOSTANDARD LVCMOS33} [get_ports {servo0}]
#set_property -dict {PACKAGE_PIN M16 IOSTANDARD LVCMOS33} [get_ports {servo1}]
#set_property -dict {PACKAGE_PIN L15 IOSTANDARD LVCMOS33} [get_ports {servo2}]
#set_property -dict {PACKAGE_PIN L16 IOSTANDARD LVCMOS33} [get_ports {servo3}]
