IamSid44/VLSI-Project/Static Implementation/FPGA/CLA_4_Bit.runs/synth_1/.Xil/Adder_propImpl.xdc

set_property SRC_FILE_INFO {cfile:{C:/Users/sidda/OneDrive/Desktop/Academics/Sem 3/VLSI Design/Project Files/VLSI-Project/Static Implementation/FPGA/CLA_4_Bit.srcs/constrs_1/new/CLA_Constraint_File.xdc} rfile:../../../CLA_4_Bit.srcs/constrs_1/new/CLA_Constraint_File.xdc id:1} [current_design]
set_property src_info {type:XDC file:1 line:3 export:INPUT save:INPUT read:READ} [current_design]
set_property CLOCK_DEDICATED_ROUTE FALSE [get_nets Clk_IBUF]
set_property src_info {type:XDC file:1 line:7 export:INPUT save:INPUT read:READ} [current_design]
set_property -dict {PACKAGE_PIN U2 IOSTANDARD LVCMOS33} [get_ports {Clk}]
set_property src_info {type:XDC file:1 line:9 export:INPUT save:INPUT read:READ} [current_design]
set_property -dict {PACKAGE_PIN T2 IOSTANDARD LVCMOS33} [get_ports {Rst}]
set_property src_info {type:XDC file:1 line:11 export:INPUT save:INPUT read:READ} [current_design]
set_property -dict {PACKAGE_PIN R2 IOSTANDARD LVCMOS33} [get_ports {Cin}]
set_property src_info {type:XDC file:1 line:13 export:INPUT save:INPUT read:READ} [current_design]
set_property -dict {PACKAGE_PIN P2 IOSTANDARD LVCMOS33} [get_ports {A[0]}]
set_property src_info {type:XDC file:1 line:14 export:INPUT save:INPUT read:READ} [current_design]
set_property -dict {PACKAGE_PIN P1 IOSTANDARD LVCMOS33} [get_ports {A[1]}]
set_property src_info {type:XDC file:1 line:15 export:INPUT save:INPUT read:READ} [current_design]
set_property -dict {PACKAGE_PIN N2 IOSTANDARD LVCMOS33} [get_ports {A[2]}]
set_property src_info {type:XDC file:1 line:16 export:INPUT save:INPUT read:READ} [current_design]
set_property -dict {PACKAGE_PIN N1 IOSTANDARD LVCMOS33} [get_ports {A[3]}]
set_property src_info {type:XDC file:1 line:18 export:INPUT save:INPUT read:READ} [current_design]
set_property -dict {PACKAGE_PIN M1 IOSTANDARD LVCMOS33} [get_ports {B[0]}]
set_property src_info {type:XDC file:1 line:19 export:INPUT save:INPUT read:READ} [current_design]
set_property -dict {PACKAGE_PIN L1 IOSTANDARD LVCMOS33} [get_ports {B[1]}]
set_property src_info {type:XDC file:1 line:20 export:INPUT save:INPUT read:READ} [current_design]
set_property -dict {PACKAGE_PIN K2 IOSTANDARD LVCMOS33} [get_ports {B[2]}]
set_property src_info {type:XDC file:1 line:21 export:INPUT save:INPUT read:READ} [current_design]
set_property -dict {PACKAGE_PIN K1 IOSTANDARD LVCMOS33} [get_ports {B[3]}]
set_property src_info {type:XDC file:1 line:24 export:INPUT save:INPUT read:READ} [current_design]
set_property -dict {PACKAGE_PIN B13 IOSTANDARD LVCMOS33} [get_ports {S[0]}]
set_property src_info {type:XDC file:1 line:25 export:INPUT save:INPUT read:READ} [current_design]
set_property -dict {PACKAGE_PIN A14 IOSTANDARD LVCMOS33} [get_ports {S[1]}]
set_property src_info {type:XDC file:1 line:26 export:INPUT save:INPUT read:READ} [current_design]
set_property -dict {PACKAGE_PIN B15 IOSTANDARD LVCMOS33} [get_ports {S[2]}]
set_property src_info {type:XDC file:1 line:27 export:INPUT save:INPUT read:READ} [current_design]
set_property -dict {PACKAGE_PIN A15 IOSTANDARD LVCMOS33} [get_ports {S[3]}]
set_property src_info {type:XDC file:1 line:28 export:INPUT save:INPUT read:READ} [current_design]
set_property -dict {PACKAGE_PIN B14 IOSTANDARD LVCMOS33} [get_ports {Cout}]
set_property src_info {type:XDC file:1 line:37 export:INPUT save:INPUT read:READ} [current_design]
set_property -dict {PACKAGE_PIN E3 IOSTANDARD LVCMOS33} [get_ports {Ain[0]}]
set_property src_info {type:XDC file:1 line:38 export:INPUT save:INPUT read:READ} [current_design]
set_property -dict {PACKAGE_PIN E5 IOSTANDARD LVCMOS33} [get_ports {Ain[1]}]
set_property src_info {type:XDC file:1 line:39 export:INPUT save:INPUT read:READ} [current_design]
set_property -dict {PACKAGE_PIN E6 IOSTANDARD LVCMOS33} [get_ports {Ain[2]}]
set_property src_info {type:XDC file:1 line:40 export:INPUT save:INPUT read:READ} [current_design]
set_property -dict {PACKAGE_PIN C3 IOSTANDARD LVCMOS33} [get_ports {Ain[3]}]
set_property src_info {type:XDC file:1 line:42 export:INPUT save:INPUT read:READ} [current_design]
set_property -dict {PACKAGE_PIN A2 IOSTANDARD LVCMOS33} [get_ports {Bin[0]}]
set_property src_info {type:XDC file:1 line:43 export:INPUT save:INPUT read:READ} [current_design]
set_property -dict {PACKAGE_PIN B3 IOSTANDARD LVCMOS33} [get_ports {Bin[1]}]
set_property src_info {type:XDC file:1 line:44 export:INPUT save:INPUT read:READ} [current_design]
set_property -dict {PACKAGE_PIN A3 IOSTANDARD LVCMOS33} [get_ports {Bin[2]}]
set_property src_info {type:XDC file:1 line:45 export:INPUT save:INPUT read:READ} [current_design]
set_property -dict {PACKAGE_PIN B4 IOSTANDARD LVCMOS33} [get_ports {Bin[3]}]
set_property src_info {type:XDC file:1 line:46 export:INPUT save:INPUT read:READ} [current_design]
set_property -dict {PACKAGE_PIN A4 IOSTANDARD LVCMOS33} [get_ports {Cin_in}]
