IamSid44/VLSI-Project/(commit log)

2024-11-09 Keeper Circuit Modified
2024-11-12 CLA Progress-1 PG Circuit
2024-11-13 Final Circuit
2024-11-29 Added TSPC Circuit Image
2024-11-29 Modified FF Circuit
